AdrienEMSE/PE-SM/Weather_Station_Componants_Pinmaps.xlsx

Sheet: Commandes
Récolte d'énergie |  |  |  |  | Composants passif
Composant | REF | lien | Disponible chez | Quantité | Composant | REF | lien | Disponible chez | Quantité | Disponible au FabLab
~~4.7μH~~ | ~~IHLP2525CZER4R7M01~~ | ~~https://fr.rs-online.com/web/p/inductances-a-montage-en-surface/7487091~~ | ~~RS~~ | ~~10~~ | Résistances
~~10μH~~ | ~~LQH32CN100K23L~~ | ~~https://fr.rs-online.com/web/p/inductances-a-montage-en-surface/4811882~~ | ~~RS~~ | ~~20~~
~~5,62kOhms~~ | ~~679-0576~~ | ~~https://fr.rs-online.com/web/p/resistances-a-montage-en-surface/6790576~~ | ~~RS~~ | ~~50~~
~~1,87kOhms~~ | ~~ 708-7506~~ | ~~https://fr.rs-online.com/web/p/resistances-a-montage-en-surface/7087506~~ | ~~RS~~ | ~~5~~ | 1,87kOhms | 215-2715 | https://fr.rs-online.com/web/p/resistances-a-montage-en-surface/2152715 | RS | 5 | non
~~4,7μF~~ | ~~ 188-2145~~ | ~~https://fr.rs-online.com/web/p/condensateurs-ceramique-multicouches/1882145~~ | ~~RS~~ | ~~25~~ | 5,62kOhms | 679-1575 | https://fr.rs-online.com/web/p/resistances-a-montage-en-surface/6791575 | RS | 50 | non
~~22μF~~ |  | ~~https://fr.rs-online.com/web/p/condensateurs-ceramique-multicouches/9159114~~ | ~~RS~~ | ~~20~~
~~10μF~~ |  | ~~https://fr.rs-online.com/web/p/condensateurs-ceramique-multicouches/6911161~~ | ~~RS~~ | ~~20~~
~~100nF~~
~~1.2k Ohms~~ | ~~565-926~~ | ~~https://fr.rs-online.com/web/p/resistances-a-montage-en-surface/0565926~~ | ~~RS~~ | ~~5~~ | 1.2k Ohms | 565-926 | https://fr.rs-online.com/web/p/resistances-a-montage-en-surface/0565926 | RS | 5 | non
~~1k Ohms~~ |  | ~~j'en ai besoin d'une et dispo par bobines de 5000~~ |  |  | 1k Ohms |  | j'en ai besoin d'une et dispo par bobines de 5000 |  |  | oui
~~100 Ohms~~ | ~~666-2437~~ | ~~https://fr.rs-online.com/web/p/resistances-a-montage-en-surface/6662437~~ | ~~RS~~ | ~~5~~ | 100 Ohms | 666-2437 | https://fr.rs-online.com/web/p/resistances-a-montage-en-surface/6662437 | RS | 5 | oui
 |  |  |  |  | 10k |  |  | RS |  | oui
 |  |  |  |  | 10M |  |  | RS |  | oui
1A, 40V Schotty Diode | 1N5819RL | https://fr.rs-online.com/web/p/diodes-schottky-et-de-redressements/7082197 | RS | 10 | 1k |  |  | RS |  | oui
boost MIC | MIC228YD5-TR | https://fr.rs-online.com/web/p/convertisseurs-dc-dc/9112736 | RS | 10 | 330k |  |  | RS |  | oui
 |  |  |  |  | 100k |  |  | RS |  | oui
 |  |  |  |  | 15k |  | https://fr.rs-online.com/web/p/resistances-a-montage-en-surface/2230584 | RS |  | non
Anémometre ultrasonique |  |  |  |  | Capacités céramique
CD4046B (THT) | 709-1965 | https://fr.rs-online.com/web/p/synthetiseurs-d-horloge/7091965 | RS | 10 | 27pF | 147-409 | https://fr.rs-online.com/web/p/condensateurs-ceramique-multicouches/0147409 | RS | 50 | oui
CD4046B (SMD) | 145-1118 | https://fr.rs-online.com/web/p/synthetiseurs-d-horloge/1451118 | RS (Non disponible) | 10 | 4,7μF | 188-2145 | https://fr.rs-online.com/web/p/condensateurs-ceramique-multicouches/1882145 | RS | 25 | oui
HCSR04 | 215-3181 | https://fr.rs-online.com/web/p/complements-bbc-micro-bit/2153181 | RS | 6 | 22μF |  | https://fr.rs-online.com/web/p/condensateurs-ceramique-multicouches/6911177 | RS | 20 | non
NPN (BSR14) | 671-1129 | https://fr.rs-online.com/web/p/transistors-bipolaires/6711129 | RS | 20 | 10μF |  | https://fr.rs-online.com/web/p/condensateurs-ceramique-multicouches/6911161 | RS | 20 | oui
Détecteur de foudre |  |  |  |  | 100p |  |  | RS |  | oui
 |  |  |  |  | 470p |  | https://fr.rs-online.com/web/p/condensateurs-ceramique-multicouches/2644315 | RS |  | non
Diode | 186-7651 | https://fr.rs-online.com/web/p/diodes-schottky-et-de-redressements/6882136 | RS | 100 | 10n |  |  | RS |  | oui
TS53YL103MR10 | 486-7526 | https://fr.rs-online.com/web/p/potentiometres-trimmer/4867526 | RS | 5 | 4,7n |  |  | RS |  | oui
 |  |  |  |  | 1u |  |  | RS |  | oui
 |  |  |  |  | 0,1u |  | https://fr.rs-online.com/web/p/condensateurs-ceramique-multicouches/1335642 | RS |  | non
MosFET | 822-2520 | https://fr.rs-online.com/web/p/transistors-mosfet/8222520 | RS | 25 | 2200p |  | https://fr.rs-online.com/web/p/condensateurs-ceramique-multicouches/2644359 | RS |  | non
 |  |  |  |  | Capacités électrolitiques
 |  |  |  |  | 100nF |  | https://fr.rs-online.com/web/p/condensateurs-electrolytiques-aluminium/8388005 | RS |  | non
 |  |  |  |  | 47u |  | https://fr.rs-online.com/web/p/condensateurs-electrolytiques-aluminium/5370657 | RS |  | non
 |  |  |  |  | Bobines
 |  |  |  |  | 4.7μH | IHLP2525CZER4R7M01 | https://fr.rs-online.com/web/p/inductances-a-montage-en-surface/7487091 | RS |  | non
 |  |  |  |  | 10μH | LQH32CN100K23L | https://fr.rs-online.com/web/p/inductances-a-montage-en-surface/4811882 | RS |  | oui

Sheet: Sensors
Sensor | Alimentation | Communication | Digital Pins | Analog Pins | Consommation moyenne th. (uA) | Placement
Air Quality + Humidity + T° + Pression | 5V | I2C1 | 1 | 0 |  | Shield Nucléo 144
GPS | 5V | Virtual UART | 0 | 0 |  | Shield Nucléo 144
DHT | 5V | Custom | 0 | 0 |  | Shield Nucléo 144
Sky Temperature | 5V | I2C2 | 0 | 0 |  | PCB Déporté
UV | 5V | I2C1 | 0 | 0 |  | PCB Déporté
Rain Detector | ∅ | ∅ | 1 | 1 |  | PCB Déporté
Brightness | 5V | I2C1 | 0 | 0 |  | PCB Déporté
Wind Gauge | 5V | ∅ | 0 | 2 |  | PCB Custom
Lightning Detector | 5V | ∅ | 0 | 1 | 600 | PCB Custom
Air Quality | 5V | UART | 0 | 0 |  | Nucléo Raspi
CO2 | 5V | Virtual UART | 0 | 0 |  | Nucléo Raspi

Sheet: PinList
Analog Pins |  | Digital Pins |  | Communication Pins
Anémomètre Phase 1 | A1 | Pluviomètre Trigger | D2 | I2C1 - SDA | D14
Anémomètre Phase 2 | A2 | Wake_css | D5 | I2C1 - SCL | D15
Signal Foudre | A3 | Reprogrammation_ESP | PG2 | I2C2 - SDA | PB11
Mesure Pluviomètre | A4 | Alimentation_GPS | D8 | I2C2 - SCL | PB10
 |  | Alimentation_DHT | D9 | UART1 - Rx | PB15
 |  | Alimentation_Skytemp | D10 | UART1 - Tx | PB6
 |  | Alimentation_pluviometre | D11 | UART3 - Rx | PD9
 |  | Acc_UV | PE_12 | UART3 - Tx | PD8
 |  | Alimentation_ESP | D13 | UART7 - Rx | PE7
 |  | Alimentation_anemo | PE_10 | UART7 - Tx | PE8
 |  |  |  | UART_ESP- GPIO13 (Rx) | D0
 |  |  |  | UART_ESP - GPIO15 (Tx) | ²
 |  |  |  | UART_GPS - Rx | D4
 |  |  |  | UART_GPS - Tx | D7
 |  |  |  | Custom_DHT | D3
 |  |  |  | SPI4 - MOSI | PE6
 |  |  |  | SPI4 - MISO | PE5
 |  |  |  | SPI4 - SCK | PE2
 |  |  |  | SPI4 - CS | PE4

Sheet: Feuille 7
Anémomètre Phase 1 | A1
Anémomètre Phase 2 | A2
Signal Foudre | A3
Mesure Pluviomètre | A4
UART_ESP - Rx | D0
UART_ESP - Tx | D1
I2C1 - SDA | D14
I2C1 - SCL | D15
Pluviomètre Trigger | D2
Custom_DHT | D3
UART_GPS - Rx | D4
Sleep_Air_Quality | D5
UART_GPS - Tx | D7
I2C2 - SCL | PB10
I2C2 - SDA | PB11
UART1 - Rx | PB15
UART1 - Tx | PB6
UART3 - Tx | PD8
UART3 - Rx | PD9
UART7 - Rx | PE7
UART7 - Tx | PE8
Reprogrammation_ESP | PG2

Sheet: PinList Serveur
Raspberry |  | Nucleo L432KC |  | PM25 | C02
5V | 2 | 5V | CH4 5V | 5V | 5V
GND | 6 | GND | CH4 GND | GND | GND
UART_Nucleo_RX_RPi_TX | 8 | UART_Nucleo_RX_RPi_TX | A2 | TX | TX
UART_RPi_RX_Nucleo_TX | 10 | UART_Nucleo_TX_RPi_RX | A7 | RX | RX
 |  | UART2_Nucleo_RX_PM25_TX | D0
 |  | UART2_Nucleo_TX_PM25_RX | D1
 |  | UART3_Nucleo_RX_CO2_TX | D2
 |  | UART3_Nucleo_TX_CO2_RX | D3
