AdrienEMSE/PE-SM/3D/Nucleo/NUCLEO-F429ZI--3DModel-STEP-56544.SLDASM

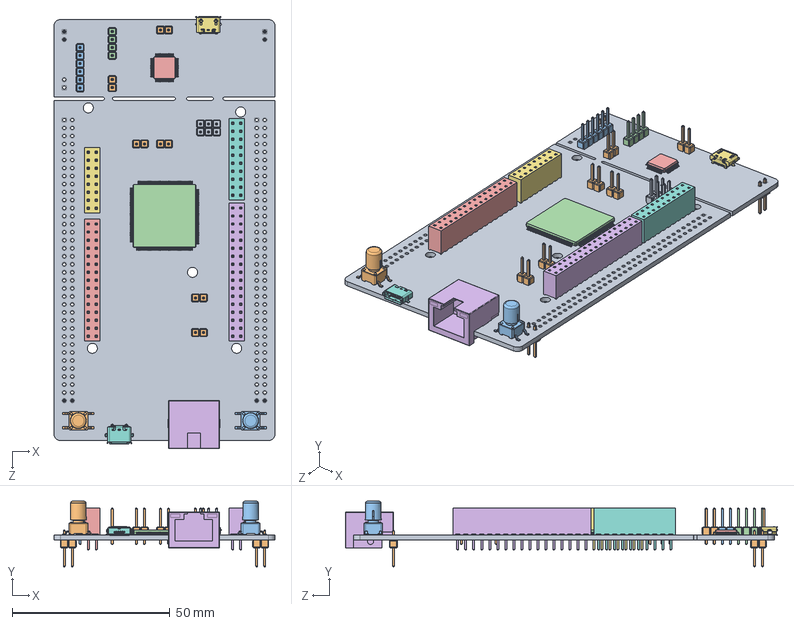
[picture p24: CAD file, 2023-03-29]
3D/Nucleo/NUCLEO-F429ZI--3DModel-STEP-56544.SLDASM
70.0 x 20.8 x 137.0 mm
NUCLEO-F429ZI board
jp1 x 10
cn6
cn4
cn9
cn10
cn1
cn13
jp3
b1
b2
STM32lqfp144
STM32F103CBT6
lan
cn8
cn7
