AdrienEMSE/PE-SM/3D/Aeration.stl

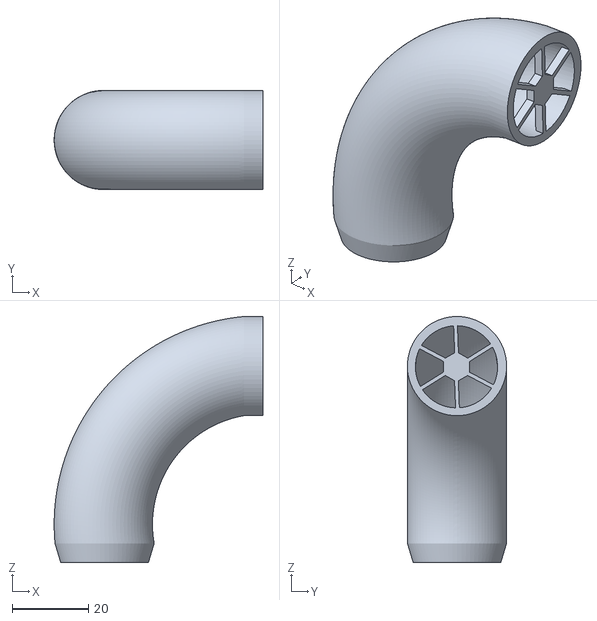
[picture p25: CAD file, 2023-03-29]
3D/Aeration.stl
54.7 x 26.0 x 64.5
