AdrienEMSE/PE-SM/3D/Door.stl

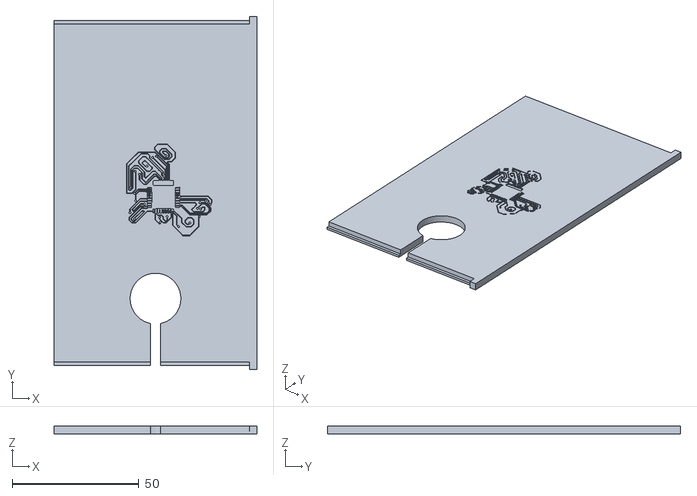
[picture p26: CAD file, 2023-03-29]
3D/Door.stl
80.0 x 139.2 x 3.00
