AdrienEMSE/PE-SM/3D/BatterieHolder.stl

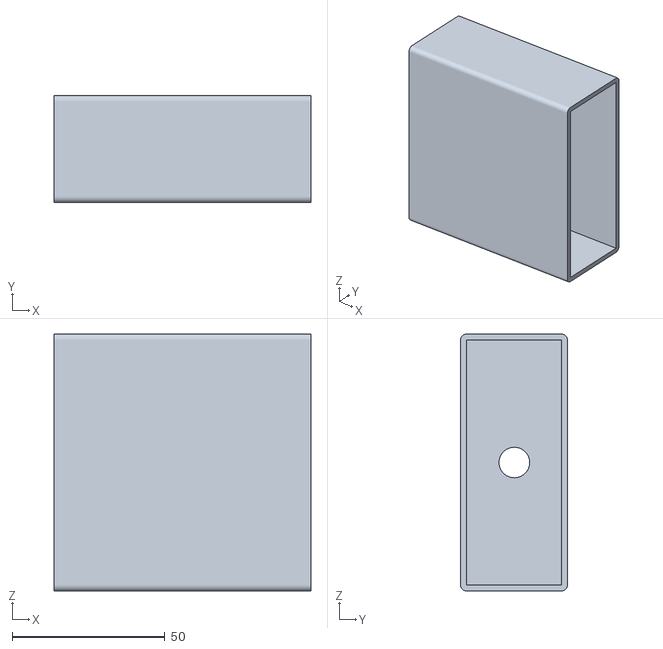
[picture p27: CAD file, 2023-03-29]
3D/BatterieHolder.stl
84.0 x 35.0 x 84.0
