AdrienEMSE/PE-SM/3D/cache_batterie_1.stl

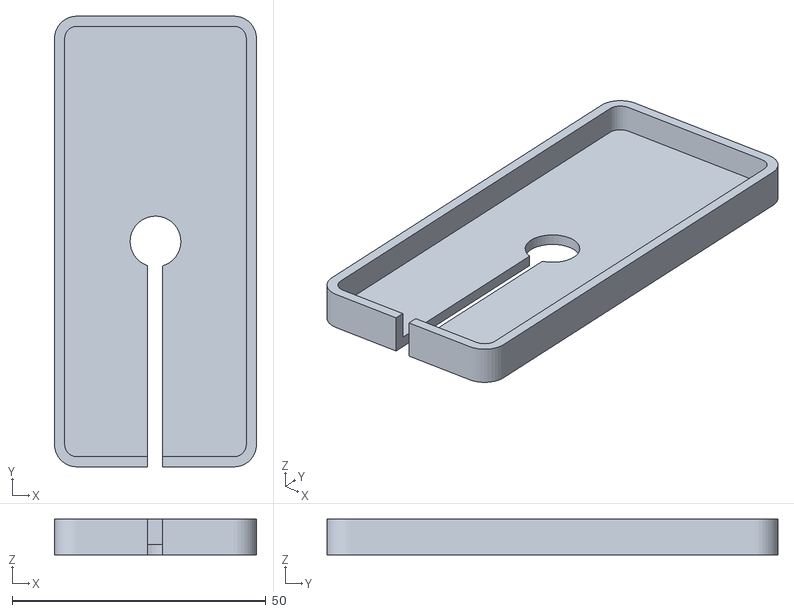
[picture p28: CAD file, 2023-03-29]
3D/cache_batterie_1.stl
39.8 x 88.8 x 7.00
