AdrienEMSE/PE-SM/3D/Cache_remote.stl

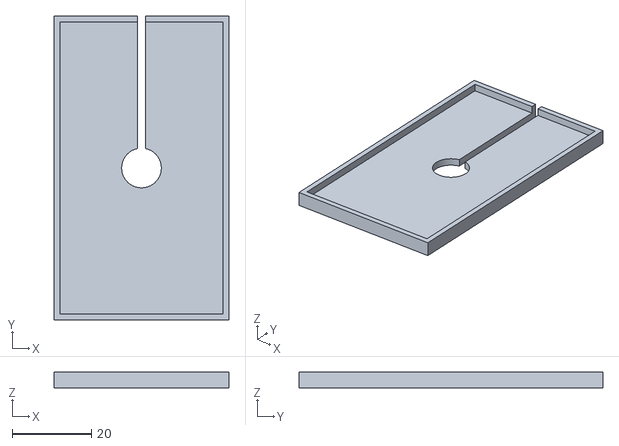
[picture p29: CAD file, 2023-03-29]
3D/Cache_remote.stl
44.0 x 76.6 x 4.00
