AdrienEMSE/PE-SM/3D/AnemoHolder.stl

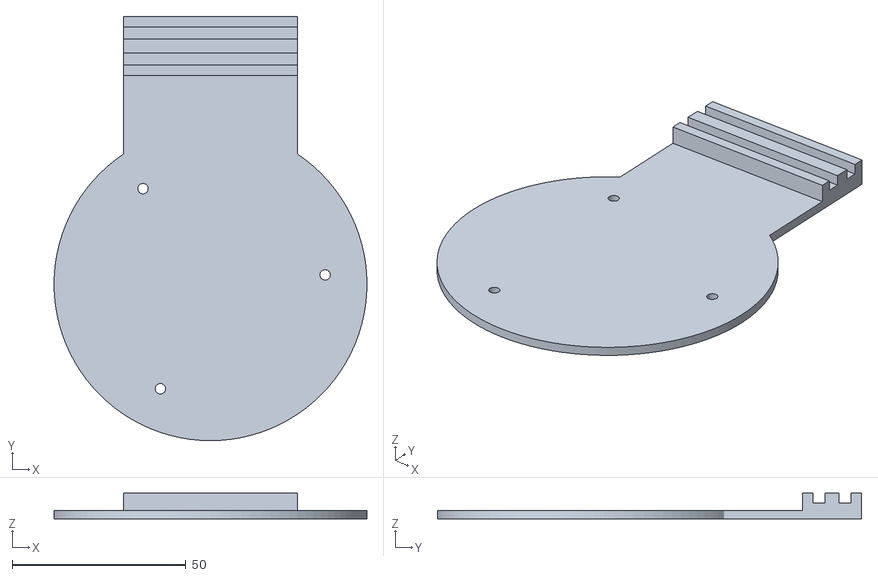
[picture p30: CAD file, 2023-03-29]
3D/AnemoHolder.stl
90.0 x 122.0 x 7.40
