AdrienEMSE/PE-SM/3D/PE.stl

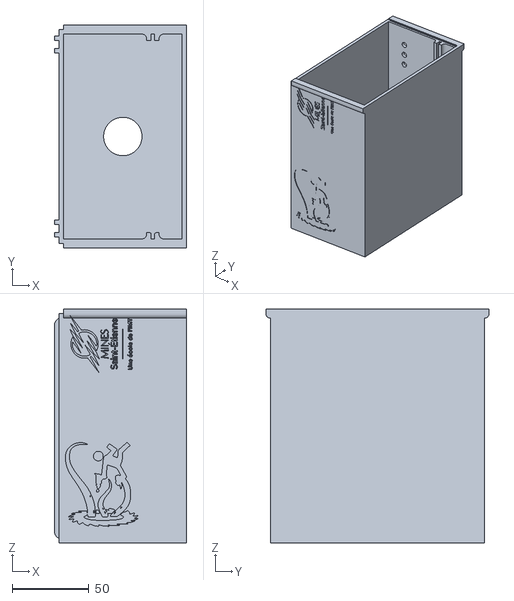
[picture p31: CAD file, 2023-03-29]
3D/PE.stl
86.0 x 145.2 x 152.2
