AdrienEMSE/PE-SM/3D/rainHolder.stl

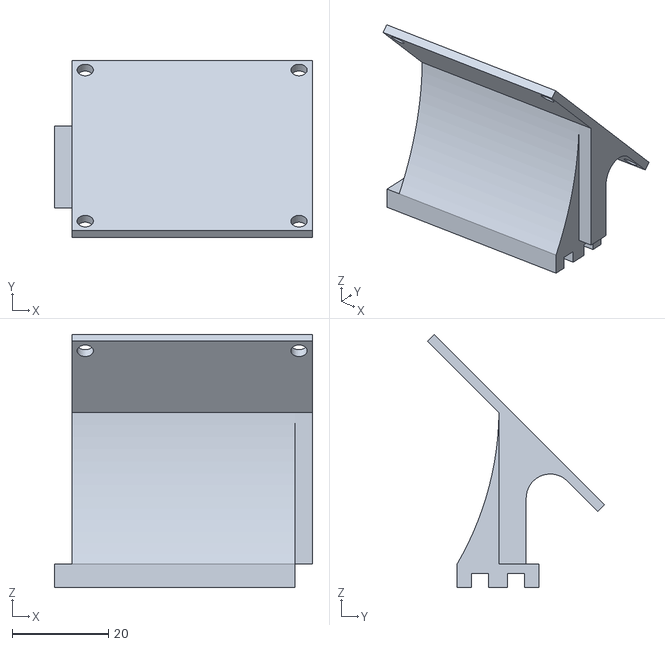
[picture p32: CAD file, 2023-03-29]
3D/rainHolder.stl
53.6 x 36.8 x 52.6
