AdrienEMSE/PE-SM/3D/SolarPanelHolder.stl

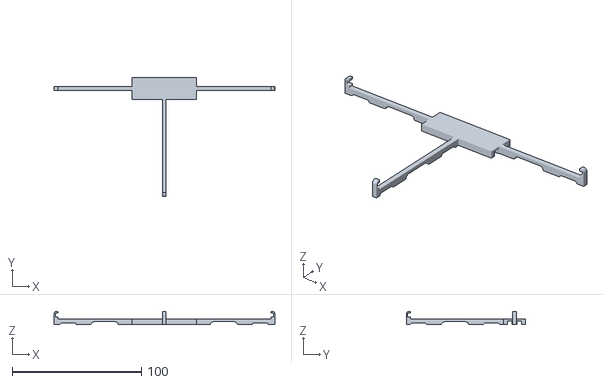
[picture p33: CAD file, 2023-03-29]
3D/SolarPanelHolder.stl
171.0 x 92.2 x 10.4
