AdrienEMSE/PE-SM/3D/Remote.stl

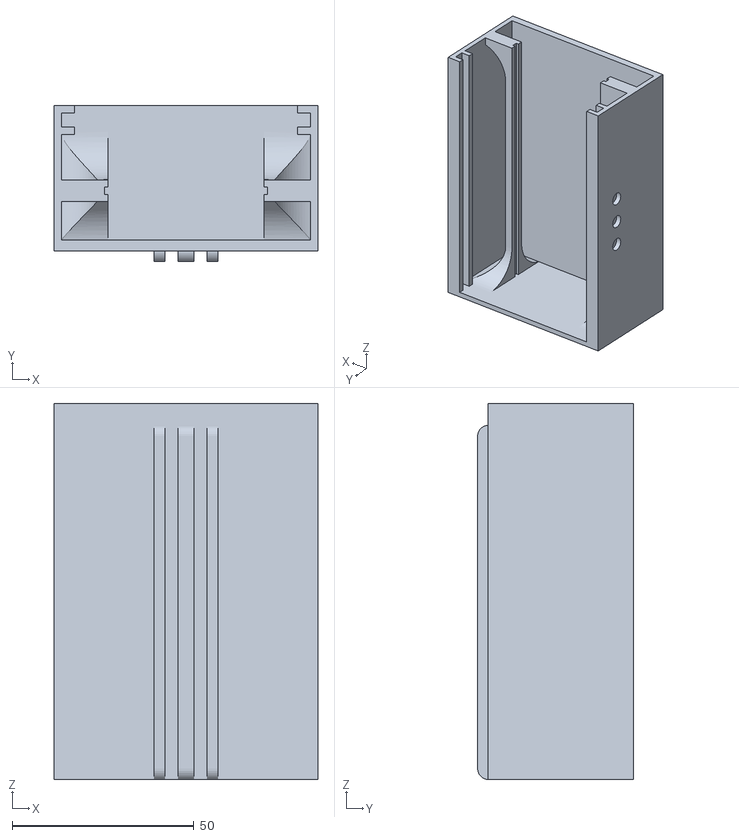
[picture p34: CAD file, 2023-03-29]
3D/Remote.stl
72.6 x 42.9 x 103.5
