AdrienEMSE/PE-SM/3D/clips Anemo.3mf

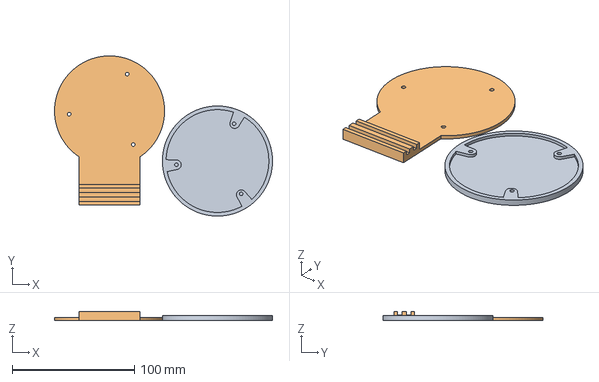
[picture p35: CAD file, 2023-03-29]
3D/clips Anemo.3mf
178.2 x 130.9 x 7.40 mm
clips Anemo.stl
AnemoHolder.stl
