AdrienEMSE/PE-SM/(list of files, cad)

Other CAD files:
3D/Nucleo/cn13.sldprt
3D/Nucleo/lan.sldprt
3D/Nucleo/NUCLEO-F429ZI board.sldprt
3D/Nucleo/STM32lqfp144.sldprt
3D/Nucleo/jp3.sldprt
3D/Nucleo/cn8.sldprt
3D/Nucleo/cn6.sldprt
3D/Nucleo/cn7.sldprt
3D/Nucleo/cn4.sldprt
3D/Nucleo/cn10.sldprt
3D/Nucleo/cn1.sldprt
3D/Nucleo/b2.sldprt
3D/Nucleo/cn9.sldprt
3D/Nucleo/b1.sldprt
3D/Nucleo/jp1.sldprt
3D/Nucleo/STM32F103CBT6.sldprt
3D/Aeration.ipt
3D/AnemoHolder.ipt
3D/Anemometre-v1.f3d
3D/Anemometre-v1.ipt
3D/BatterieHolder.ipt
3D/Cache_batterie.ipt
3D/Cache_remote.ipt
3D/Door.ipt
3D/Ensemble.iam
3D/OldVersions/AnemoHolder.0002.ipt
3D/OldVersions/BatterieHolder.0002.ipt
3D/OldVersions/Ensemble.0001.iam
3D/OldVersions/cache_batterie_1.0001.ipt
3D/Remote.iam
3D/Remote.ipt
3D/SolarPanelHolder.ipt
3D/batterieEtCacheBatterie.iam
3D/cache_batterie_1.ipt
3D/clips Anemo.ipt
3D/clips Anemo.stl
3D/rainHolder.ipt
3D/raspberry 3d case/base.ipt
3D/raspberry 3d case/piece_interieur.ipt
3D/raspberry 3d case/pied.ipt
