AdrienEMSE/PE-SM/3D/Nucleo/NUCLEO-F429ZI--3DModel-STEP-56544-2.JPG

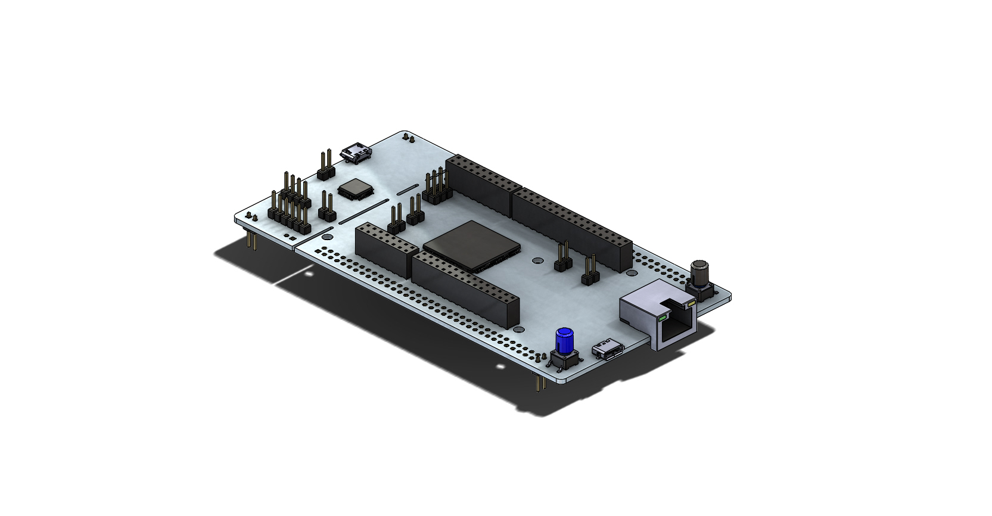
3D/Nucleo/NUCLEO-F429ZI--3DModel-STEP-56544-2.JPG
