AdrienEMSE/PE-SM/Kicad/Shield_Nucleo144/Shield_Nucleo144.kicad_pcb

## KiCad design Kicad/Shield_Nucleo144/Shield_Nucleo144.kicad_pcb (2023-03-29)

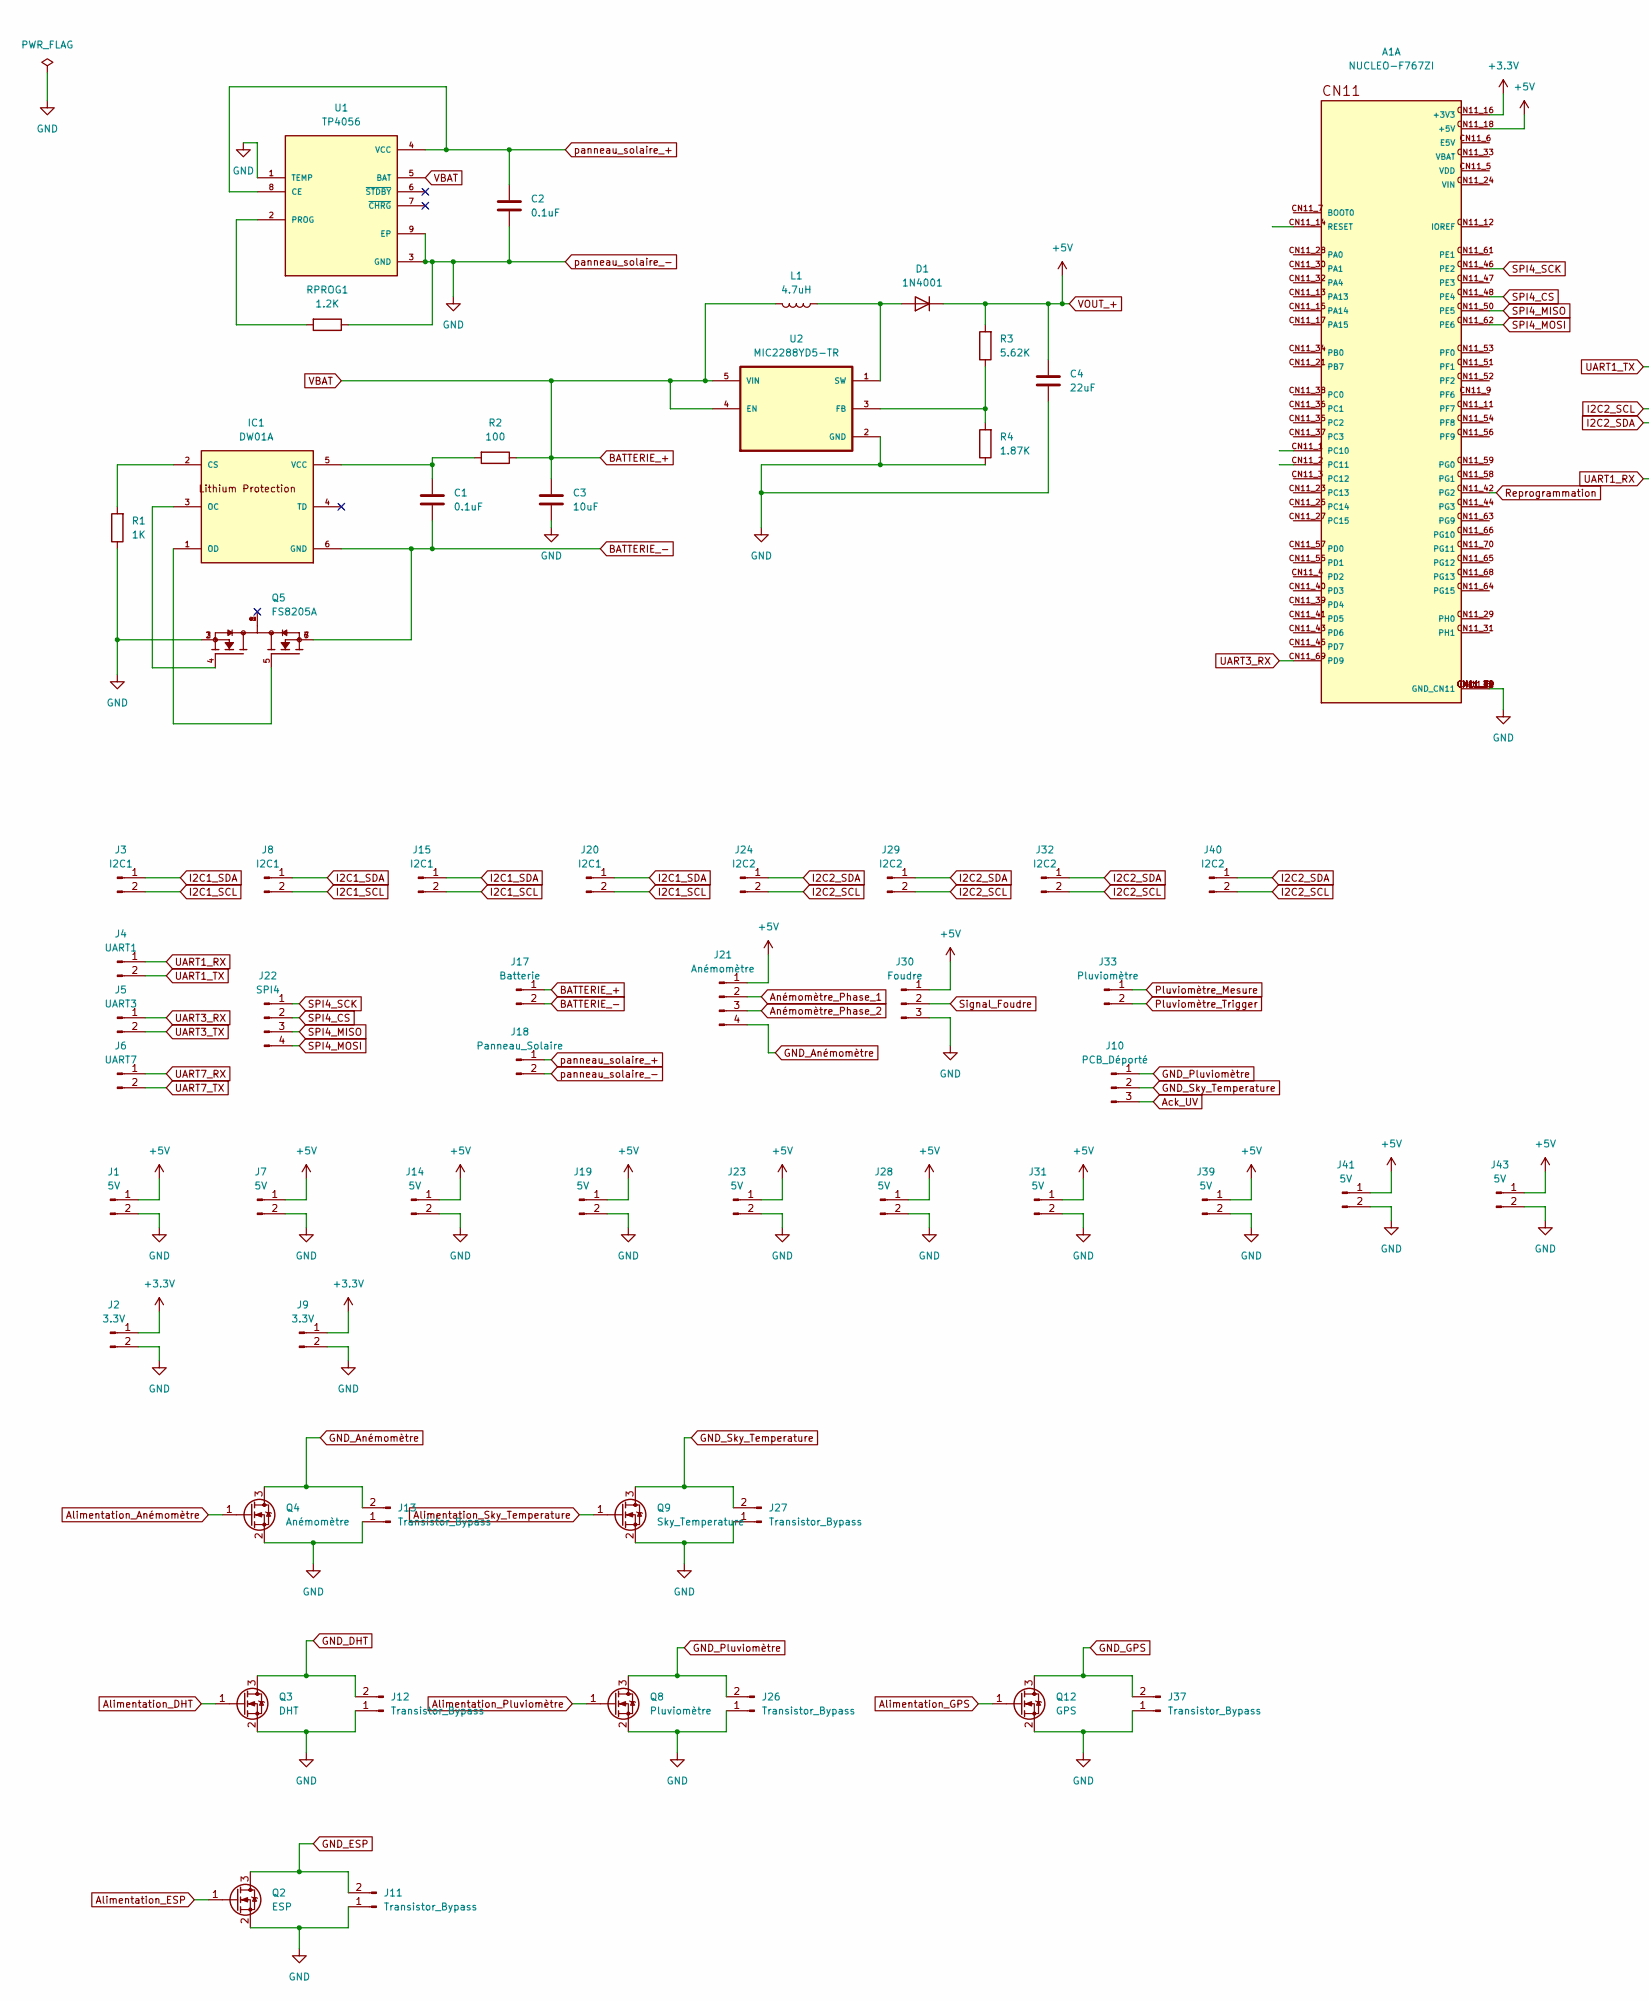
[picture p38: schematic Shield_Nucleo144.kicad_sch, part in row 1, column 1]

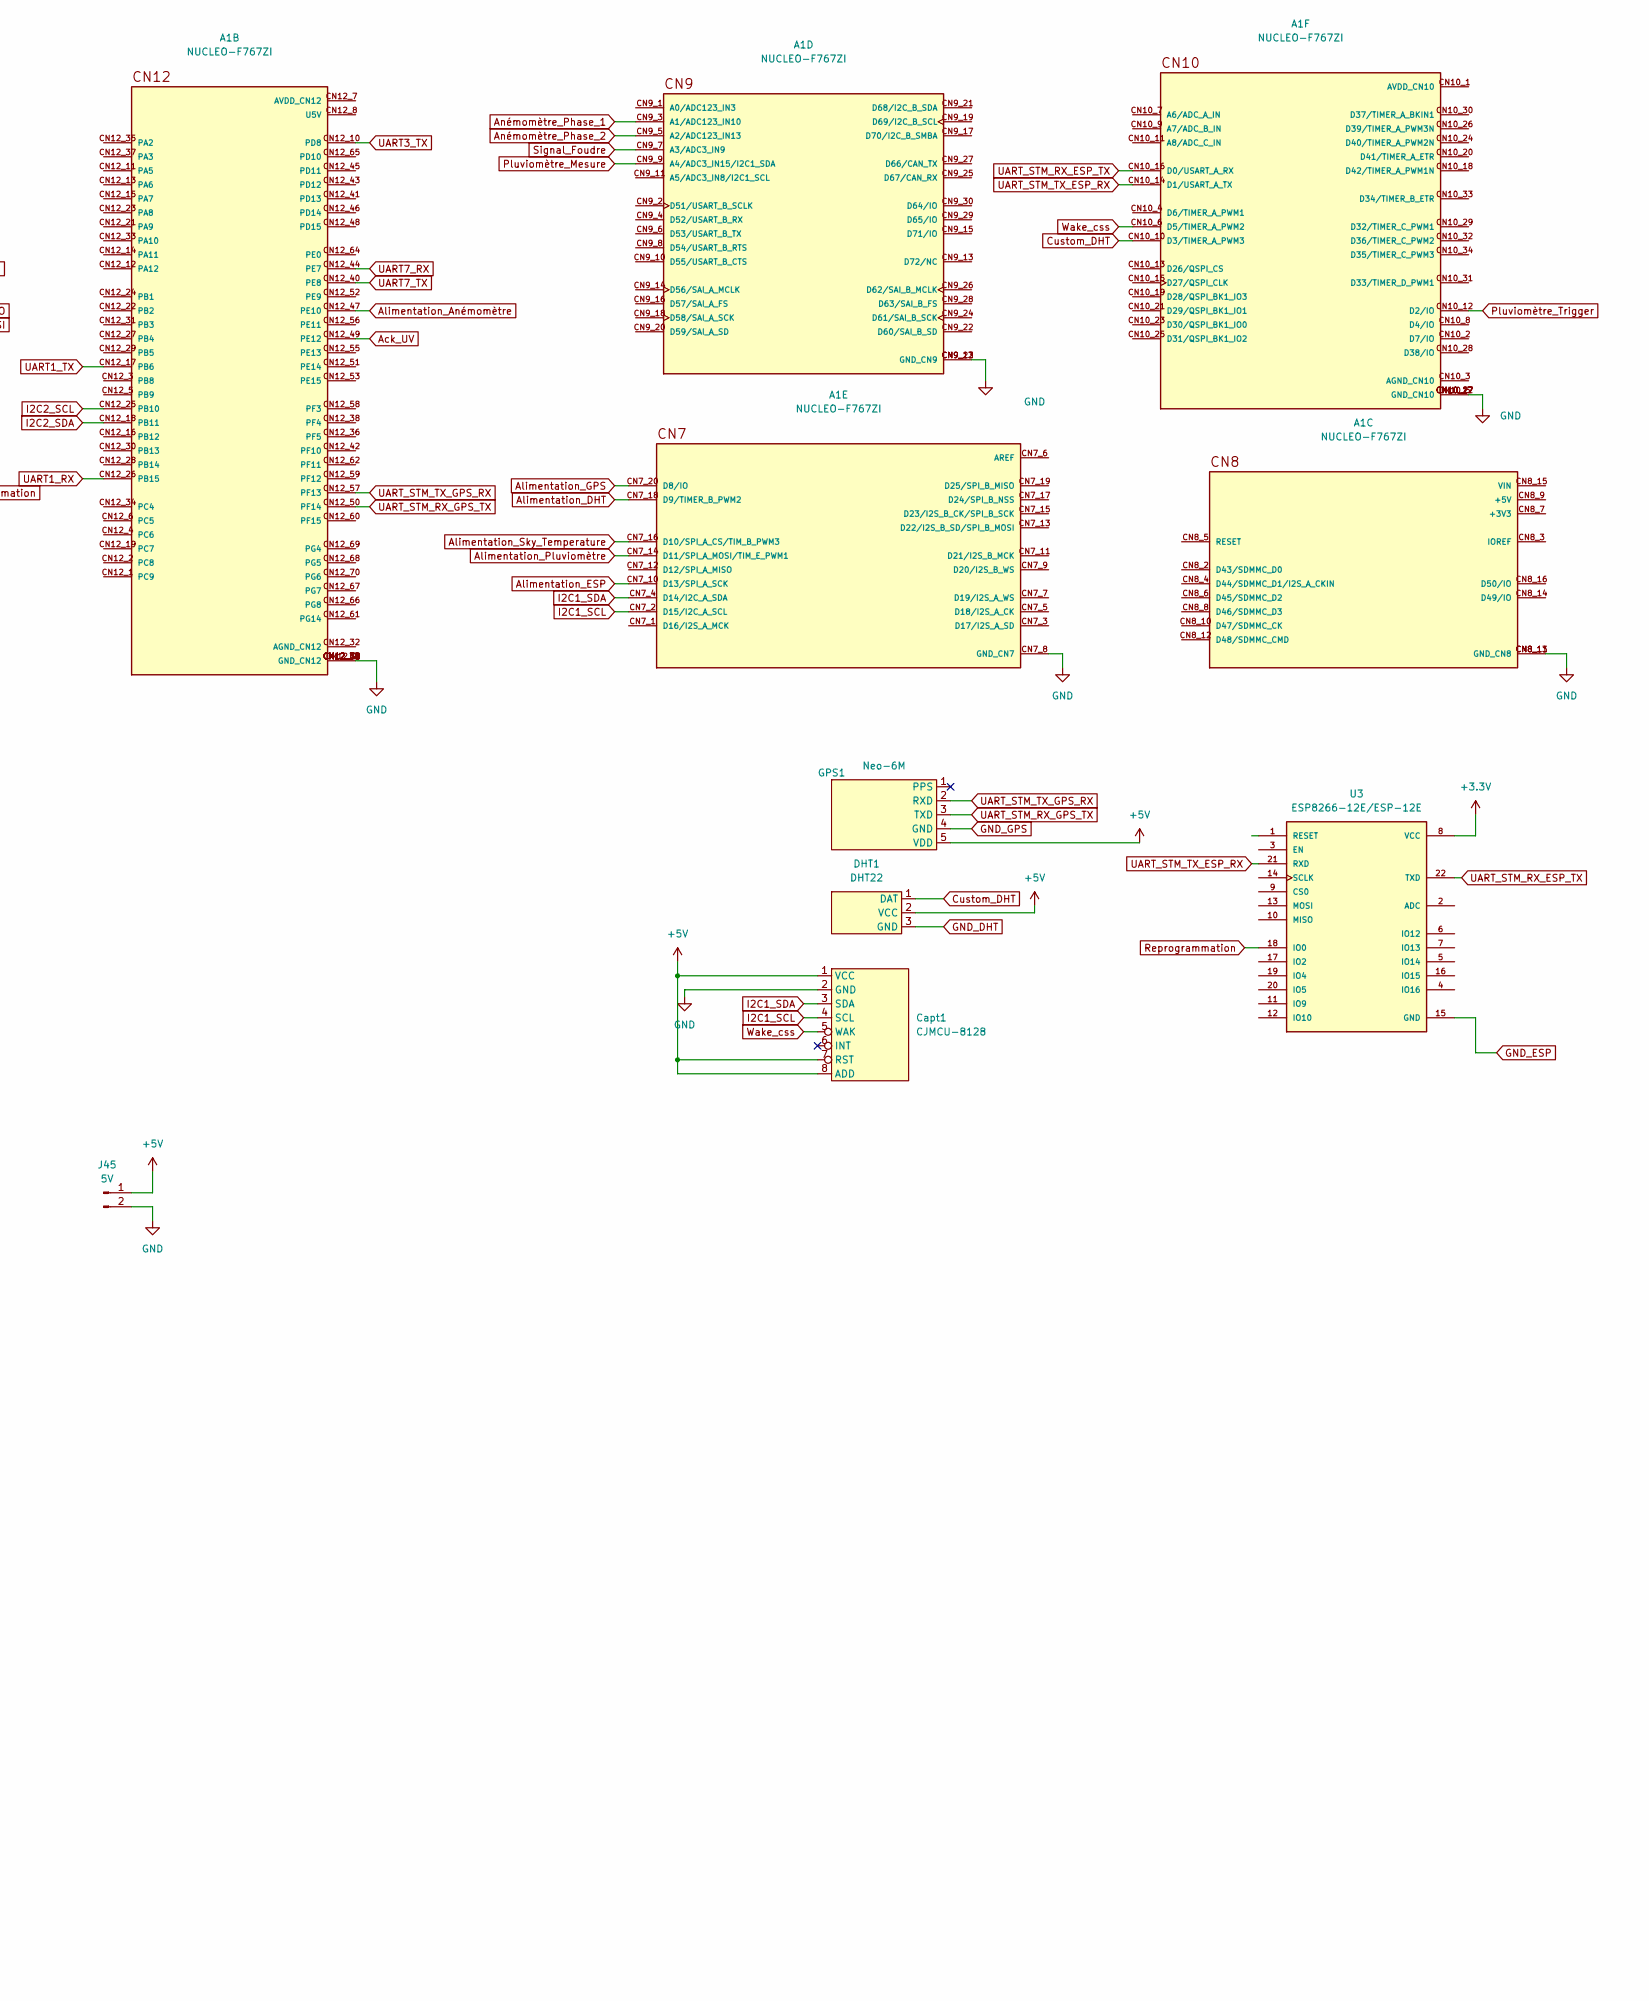
[picture p39: schematic Shield_Nucleo144.kicad_sch, part in row 1, column 2]

Parts:
A1: NUCLEO-F767ZI; ST_NUCLEO-F767ZI; PARTREV 7
C1, C2: 0.1uF; C_0603_1608Metric
C3: 10uF; C_0603_1608Metric
C4: 22uF; C_0805_2012Metric
Capt1: CJMCU-8128; AQHT
D1: 1N4001; D_SOD-123
DHT1: DHT22; DHT
GPS1: Neo-6M; GPS
IC1: DW01A; SOT-23-6; MPN DW01A; LCSC C351410
J1, J7, J14, J19, J23, J28, J31, J39, J41, J43, J45: 5V; JST_EH_B2B-EH-A_1x02_P2.50mm_Vertical
J2, J9: 3.3V; JST_EH_B2B-EH-A_1x02_P2.50mm_Vertical
J3, J8, J15, J20: I2C1; JST_EH_B2B-EH-A_1x02_P2.50mm_Vertical
J4: UART1; JST_EH_B2B-EH-A_1x02_P2.50mm_Vertical
J5: UART3; JST_EH_B2B-EH-A_1x02_P2.50mm_Vertical
J6: UART7; JST_EH_B2B-EH-A_1x02_P2.50mm_Vertical
J10: PCB_Déporté; JST_EH_B3B-EH-A_1x03_P2.50mm_Vertical
J11, J12, J13, J26, J27, J37: Transistor_Bypass; PinHeader_1x02_P2.54mm_Vertical
J17: Batterie; JST_EH_B2B-EH-A_1x02_P2.50mm_Vertical
J18: Panneau_Solaire; JST_EH_B2B-EH-A_1x02_P2.50mm_Vertical
J21: Anémomètre; JST_EH_B4B-EH-A_1x04_P2.50mm_Vertical
J22: SPI4; JST_EH_B4B-EH-A_1x04_P2.50mm_Vertical
J24, J29, J32, J40: I2C2; JST_EH_B2B-EH-A_1x02_P2.50mm_Vertical
J30: Foudre; JST_EH_B3B-EH-A_1x03_P2.50mm_Vertical
J33: Pluviomètre; JST_EH_B2B-EH-A_1x02_P2.50mm_Vertical
L1: 4.7uH; L_Vishay_IHLP-2525
Q2: ESP; SOT-23
Q3: DHT; SOT-23
Q4: Anémomètre; SOT-23
Q5: FS8205A; SOP65P640X120-8N; PARTREV 1.7
Q8: Pluviomètre; SOT-23
Q9: Sky_Temperature; SOT-23
Q12: GPS; SOT-23
R1: 1K; R_0603_1608Metric
R2: 100; R_0603_1608Metric
R3: 5.62K; R_0805_2012Metric
R4: 1.87K; R_0805_2012Metric
RPROG1: 1.2K; R_0805_2012Metric
U1: TP4056; SOP127P600X175-9N
U2: MIC2288YD5-TR; TSOT-23-5; PARTREV B
U3: ESP8266-12E/ESP-12E; ESP8233

Connections:
+3.3V: A1.CN11_16 (+3V3), J2.1, J9.1, U3.8 (VCC)
Ack_UV: A1.CN12_49 (PE12), J10.3
Alimentation_Anémomètre: A1.CN12_47 (PE10), Q4.1 (G)
Alimentation_DHT: A1.CN7_18 (D9/TIMER_B_PWM2), Q3.1 (G)
Alimentation_ESP: A1.CN7_10 (D13/SPI_A_SCK), Q2.1 (G)
Alimentation_GPS: A1.CN7_20 (D8/IO), Q12.1 (G)
Alimentation_Pluviomètre: A1.CN7_14 (D11/SPI_A_MOSI/TIM_E_PWM1), Q8.1 (G)
Alimentation_Sky_Temperature: A1.CN7_16 (D10/SPI_A_CS/TIM_B_PWM3), Q9.1 (G)
Anémomètre_Phase_1: A1.CN9_3 (A1/ADC123_IN10), J21.2
Anémomètre_Phase_2: A1.CN9_5 (A2/ADC123_IN13), J21.3
BATTERIE_+: C3.1, J17.1, L1.2, R2.1, U1.5 (BAT), U2.4 (EN), U2.5 (VIN)
BATTERIE_-: C1.2, IC1.6 (GND), J17.2, Q5.6, Q5.7
Custom_DHT: A1.CN10_10 (D3/TIMER_A_PWM3), DHT1.1 (DAT)
GND_Anémomètre: J13.2, J21.4, Q4.3 (D)
GND_DHT: DHT1.3 (GND), J12.2, Q3.3 (D)
GND_ESP: J11.2, Q2.3 (D), U3.15 (GND)
GND_GPS: GPS1.4 (GND), J37.2, Q12.3 (D)
GND_Pluviomètre: J10.1, J26.2, Q8.3 (D)
GND_Sky_Temperature: J10.2, J27.2, Q9.3 (D)
I2C1_SCL: A1.CN7_2 (D15/I2C_A_SCL), Capt1.4 (SCL), J3.2, J8.2, J15.2, J20.2
I2C1_SDA: A1.CN7_4 (D14/I2C_A_SDA), Capt1.3 (SDA), J3.1, J8.1, J15.1, J20.1
I2C2_SCL: A1.CN12_25 (PB10), J24.2, J29.2, J32.2, J40.2
I2C2_SDA: A1.CN12_18 (PB11), J24.1, J29.1, J32.1, J40.1
unnamed: C1.1, IC1.5 (VCC), R2.2
unnamed: D1.2 (A), L1.1, U2.1 (SW)
unnamed: IC1.1 (OD), Q5.5
unnamed: IC1.2 (CS), R1.2
unnamed: IC1.3 (OC), Q5.4
unnamed: R3.1, R4.2, U2.3 (FB)
unnamed: RPROG1.2, U1.2 (PROG)
Pluviomètre_Mesure: A1.CN9_9 (A4/ADC3_IN15/I2C1_SDA), J33.1
Pluviomètre_Trigger: A1.CN10_12 (D2/IO), J33.2
Reprogrammation: A1.CN11_42 (PG2), U3.18 (IO0)
SPI4_CS: A1.CN11_48 (PE4), J22.2
SPI4_MISO: A1.CN11_50 (PE5), J22.3
SPI4_MOSI: A1.CN11_62 (PE6), J22.4
SPI4_SCK: A1.CN11_46 (PE2), J22.1
Signal_Foudre: A1.CN9_7 (A3/ADC3_IN9), J30.2
UART1_RX: A1.CN12_26 (PB15), J4.1
UART1_TX: A1.CN12_17 (PB6), J4.2
UART3_RX: A1.CN11_69 (PD9), J5.1
UART3_TX: A1.CN12_10 (PD8), J5.2
UART7_RX: A1.CN12_44 (PE7), J6.1
UART7_TX: A1.CN12_40 (PE8), J6.2
UART_STM_RX_ESP_TX: A1.CN10_16 (D0/USART_A_RX), U3.22 (TXD)
UART_STM_RX_GPS_TX: A1.CN12_50 (PF14), GPS1.3 (TXD)
UART_STM_TX_ESP_RX: A1.CN10_14 (D1/USART_A_TX), U3.21 (RXD)
UART_STM_TX_GPS_RX: A1.CN12_57 (PF13), GPS1.2 (RXD)
VOUT_+: A1.CN11_18 (+5V), C4.1, Capt1.1 (VCC), Capt1.7 (RST), Capt1.8 (ADD), D1.1 (K), DHT1.2 (VCC), GPS1.5 (VDD), J1.1, J7.1, J14.1, J19.1, J21.1, J23.1, J28.1, J30.1, J31.1, J39.1, J41.1, J43.1, J45.1, R3.2
Wake_css: A1.CN10_6 (D5/TIMER_A_PWM2), Capt1.5 (WAK)
panneau_solaire_+: C2.1, J18.1, U1.4 (VCC), U1.8 (CE)
panneau_solaire_-: A1.CN7_8 (GND_CN7), A1.CN8_11 (GND_CN8), A1.CN8_13 (GND_CN8), A1.CN9_12 (GND_CN9), A1.CN9_23 (GND_CN9), A1.CN10_5 (GND_CN10), A1.CN10_17 (GND_CN10), A1.CN10_22 (GND_CN10), A1.CN10_27 (GND_CN10), A1.CN11_8 (GND_CN11), A1.CN11_19 (GND_CN11), A1.CN11_20 (GND_CN11), A1.CN11_22 (GND_CN11), A1.CN11_49 (GND_CN11), A1.CN11_60 (GND_CN11), A1.CN11_71 (GND_CN11), A1.CN11_72 (GND_CN11), A1.CN12_9 (GND_CN12), A1.CN12_20 (GND_CN12), A1.CN12_39 (GND_CN12), A1.CN12_54 (GND_CN12), A1.CN12_63 (GND_CN12), A1.CN12_71 (GND_CN12), A1.CN12_72 (GND_CN12), C2.2, C3.2, C4.2, Capt1.2 (GND), J1.2, J2.2, J7.2, J9.2, J11.1, J12.1, J13.1, J14.2, J18.2, J19.2, J23.2, J26.1, J27.1, J28.2, J30.3, J31.2, J37.1, J39.2, J41.2, J43.2, J45.2, Q2.2 (S), Q3.2 (S), Q4.2 (S), Q5.2, Q5.3, Q8.2 (S), Q9.2 (S), Q12.2 (S), R1.1, R4.1, RPROG1.1, U1.1 (TEMP), U1.3 (GND), U1.9 (EP), U2.2 (GND)

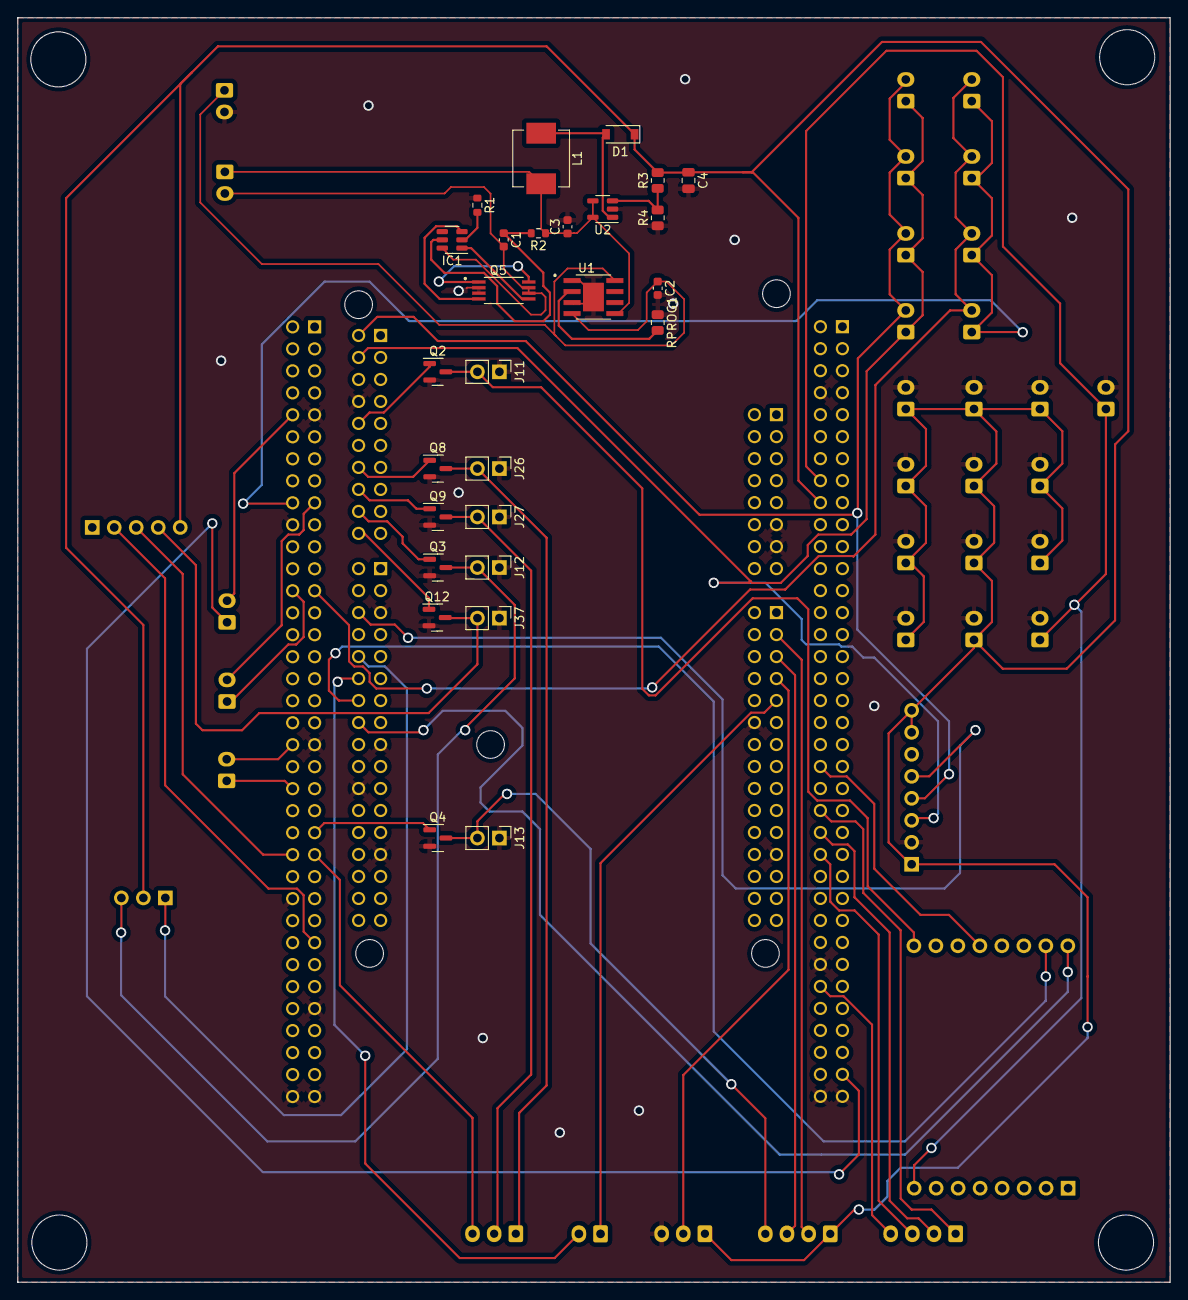
[picture p40: board Shield_Nucleo144.kicad_pcb from above]

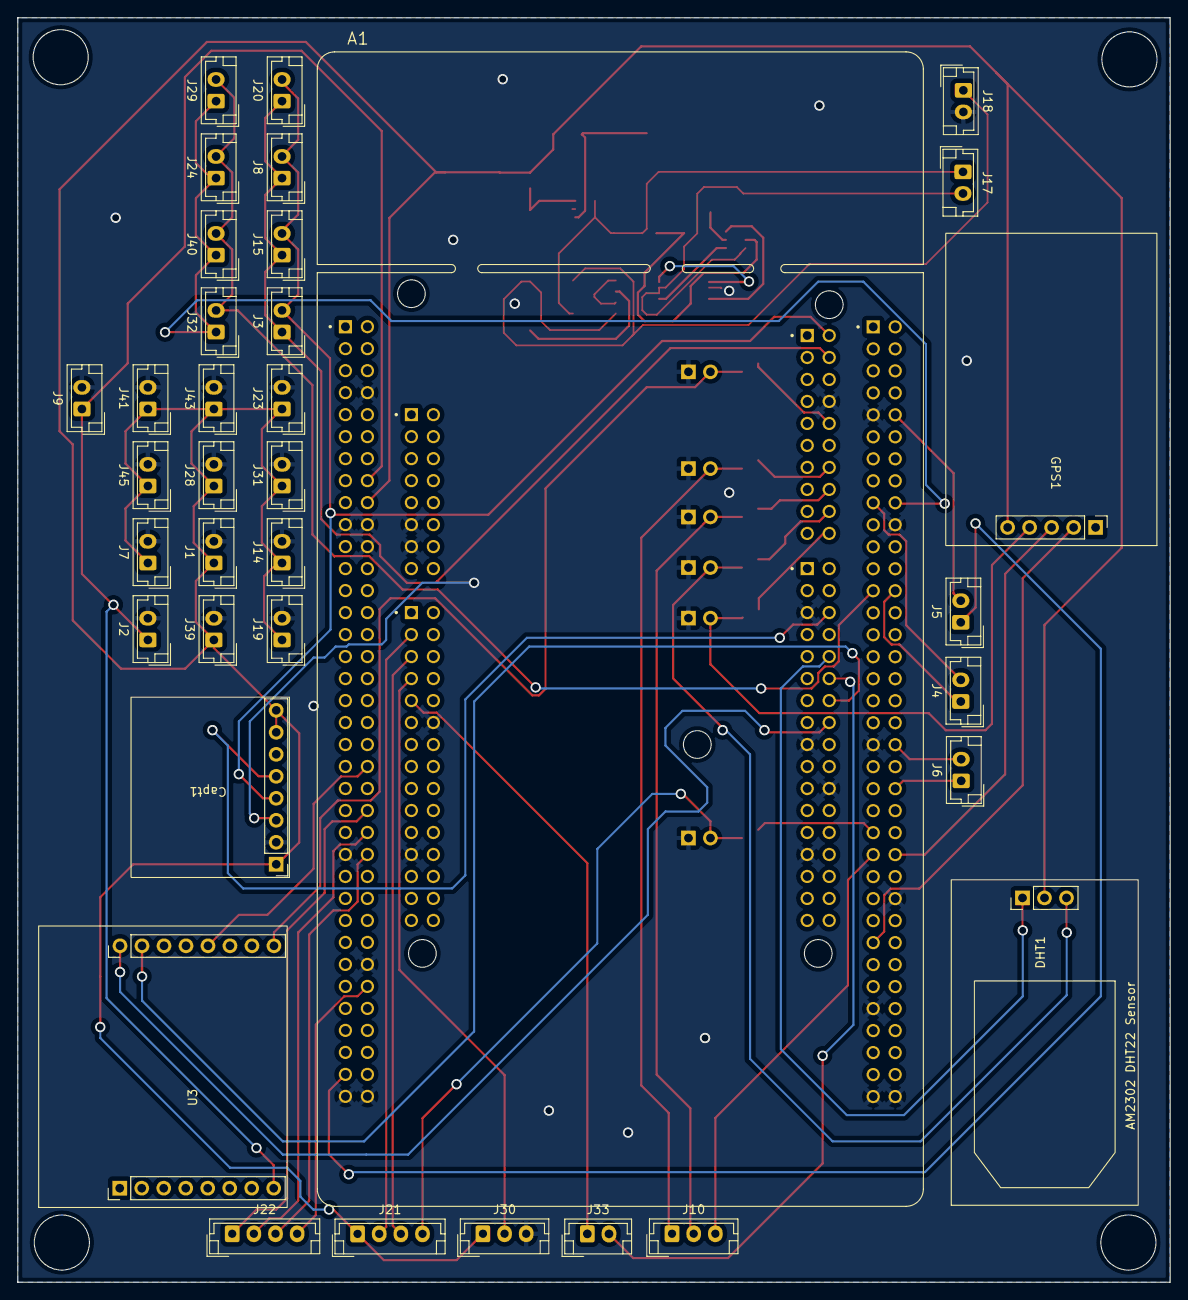
[picture p41: board Shield_Nucleo144.kicad_pcb from below]

Board: 2 copper layers, 133.1 x 146.0 mm, 63 parts (36 on the bottom side), 52 nets.
