AdrienEMSE/PE-SM/Kicad/Shield_Raspy/Shield_Raspy.kicad_pcb

## KiCad design Kicad/Shield_Raspy/Shield_Raspy.kicad_pcb (2023-03-29)

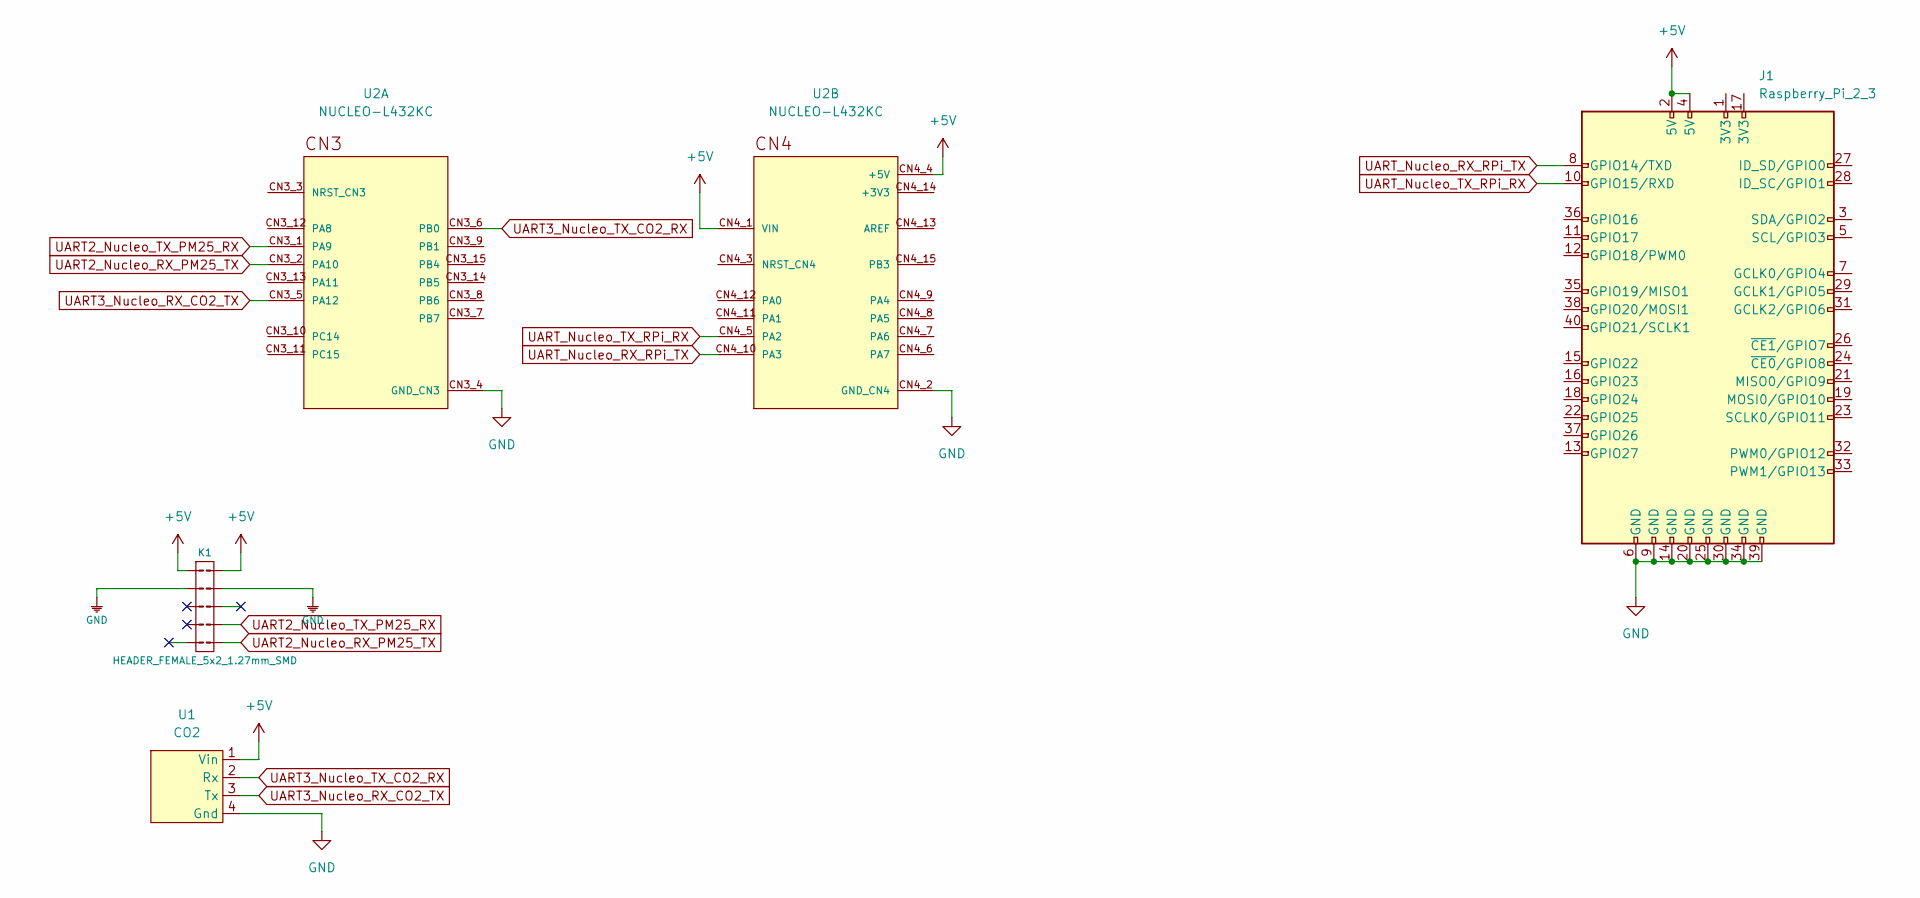
[picture p42: schematic Shield_Raspy.kicad_sch]

Parts:
J1: Raspberry_Pi_2_3; MODULE_RASPBERRY_PI_3_MODEL_B+
K1: HEADER_FEMALE_5x2_1.27mm_SMD; PinHeader_2x05_P1.27mm_Vertical
U1: CO2
U2: NUCLEO-L432KC; MODULE_NUCLEO-L432KC; PARTREV N/A

Connections:
+5V: J1.2 (5V), J1.4 (5V), K1.1, K1.2, U1.1 (Vin), U2.CN4_1 (VIN)
GND: J1.6 (GND), J1.9 (GND), J1.14 (GND), J1.20 (GND), J1.25 (GND), J1.30 (GND), J1.34 (GND), J1.39 (GND), K1.3, K1.4, U1.4 (Gnd), U2.CN3_4 (GND_CN3), U2.CN4_2 (GND_CN4)
UART2_Nucleo_RX_PM25_TX: K1.10, U2.CN3_2 (PA10)
UART2_Nucleo_TX_PM25_RX: K1.8, U2.CN3_1 (PA9)
UART3_Nucleo_RX_CO2_TX: U1.3 (Tx), U2.CN3_5 (PA12)
UART3_Nucleo_TX_CO2_RX: U1.2 (Rx), U2.CN3_6 (PB0)
UART_Nucleo_RX_RPi_TX: J1.8 (GPIO14/TXD), U2.CN4_10 (PA3)
UART_Nucleo_TX_RPi_RX: J1.10 (GPIO15/RXD), U2.CN4_5 (PA2)

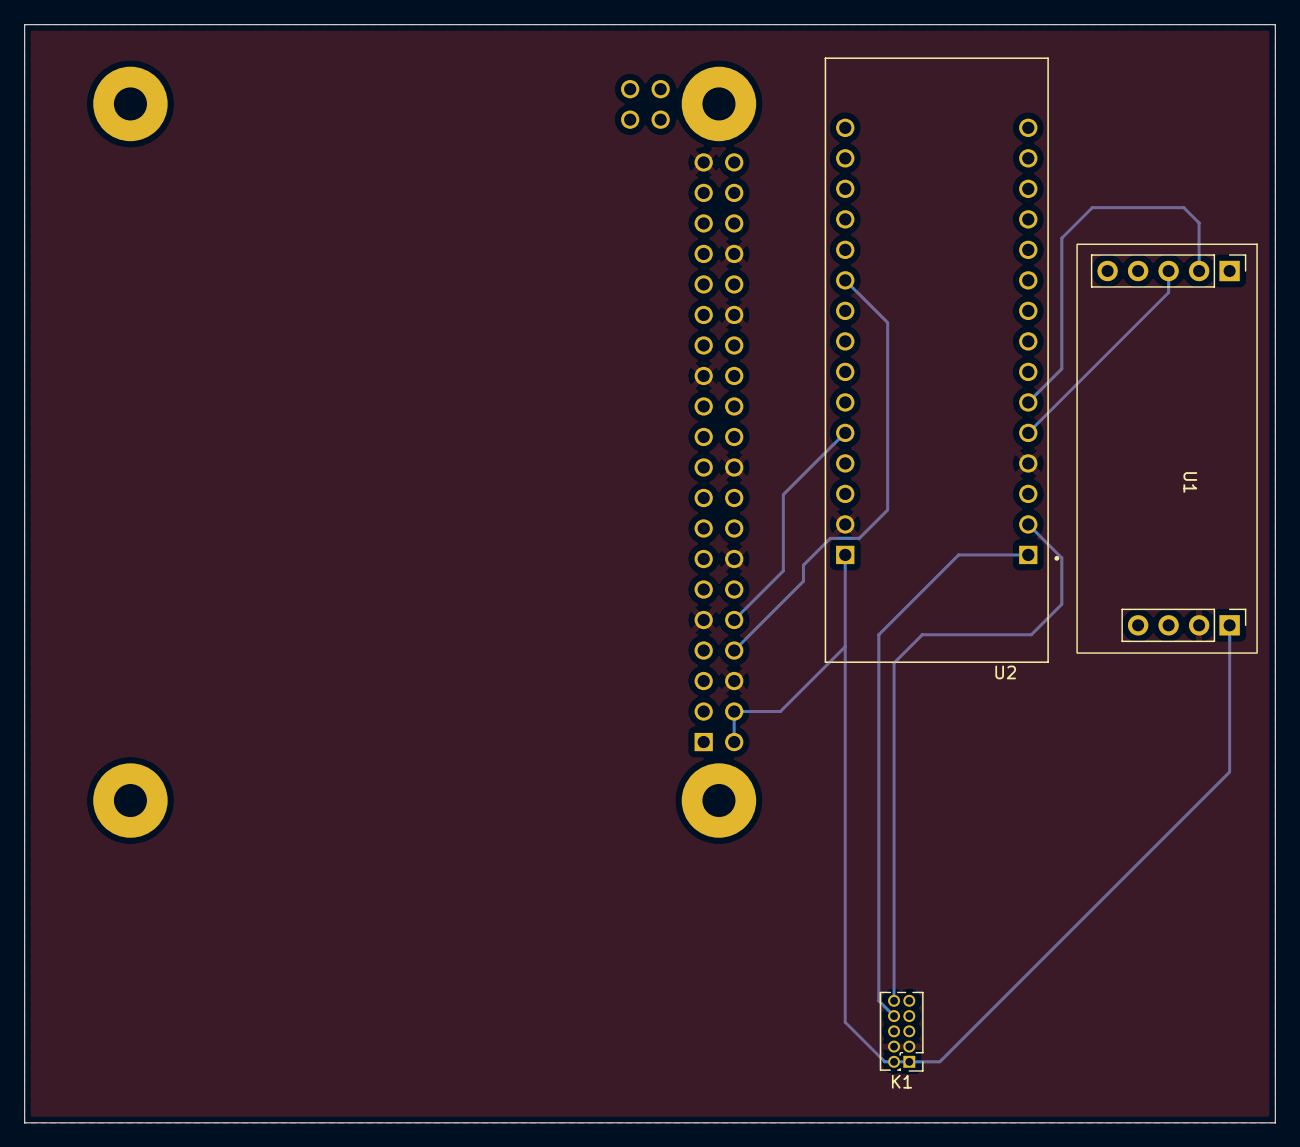
[picture p43: board Shield_Raspy.kicad_pcb from above]

Board: 2 copper layers, 104.1 x 91.4 mm, 4 parts (1 on the bottom side), 8 nets.
