AdrienEMSE/PE-SM/Kicad/Boost/Boost.kicad_pcb

## KiCad design Kicad/Boost/Boost.kicad_pcb (2023-03-16)

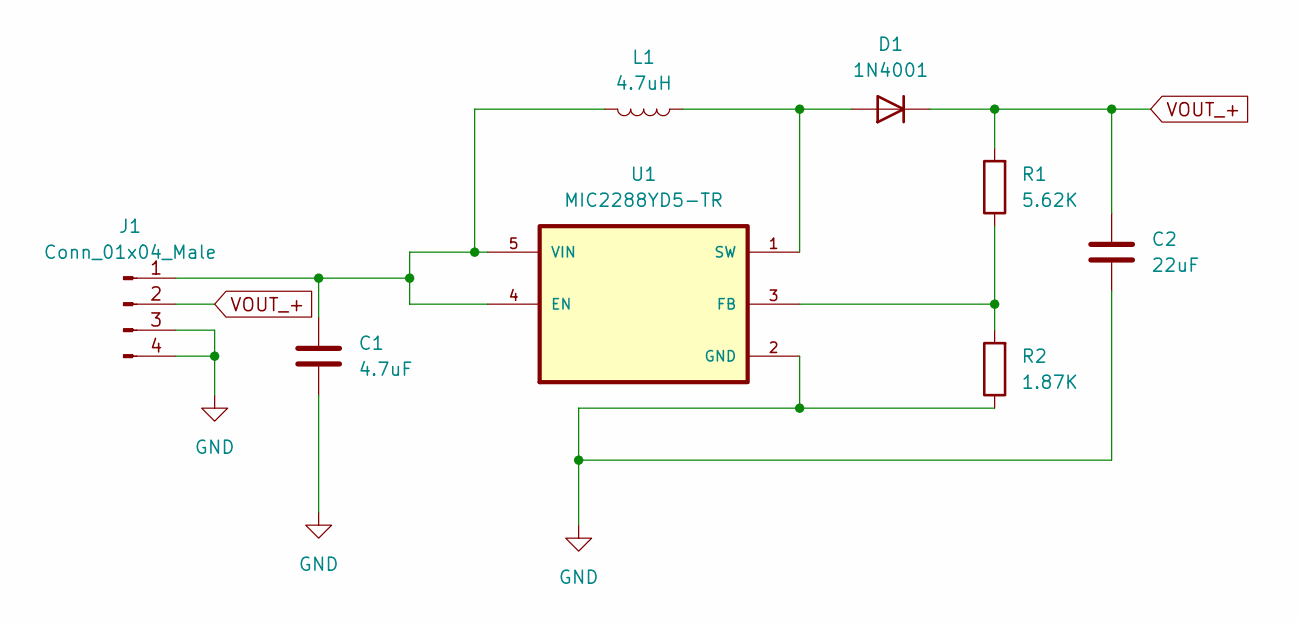
[picture p44: schematic Boost.kicad_sch]

Parts:
C1: 4.7uF; C_0603_1608Metric
C2: 22uF; C_0805_2012Metric
D1: 1N4001; D_SOD-123
J1: Conn_01x04_Male; PinHeader_1x04_P2.54mm_Vertical
L1: 4.7uH; L_Vishay_IHLP-2525
R1: 5.62K; R_0805_2012Metric
R2: 1.87K; R_0805_2012Metric
U1: MIC2288YD5-TR; TSOT-23-5; PARTREV B

Connections:
GND: C1.2, C2.2, J1.3, J1.4, R2.1, U1.2 (GND)
unnamed: C1.1, J1.1, L1.2, U1.4 (EN), U1.5 (VIN)
unnamed: D1.2 (A), L1.1, U1.1 (SW)
unnamed: R1.1, R2.2, U1.3 (FB)
VOUT_+: C2.1, D1.1 (K), J1.2, R1.2

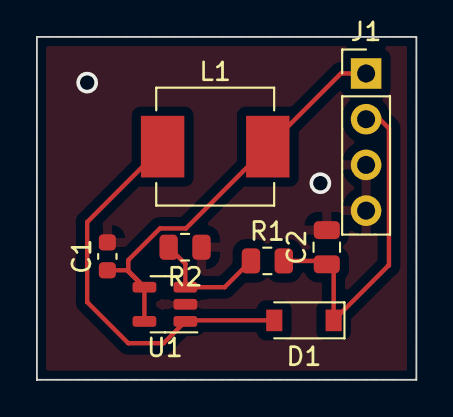
[picture p45: board Boost.kicad_pcb from above]

Board: 2 copper layers, 21.1 x 19.0 mm, 8 parts (0 on the bottom side), 5 nets.
