AdrienEMSE/PE-SM/Kicad/Capteur de fourdre/Capteur de fourdre.kicad_pcb

## KiCad design Kicad/Capteur de fourdre/Capteur de fourdre.kicad_pcb (2023-03-16)

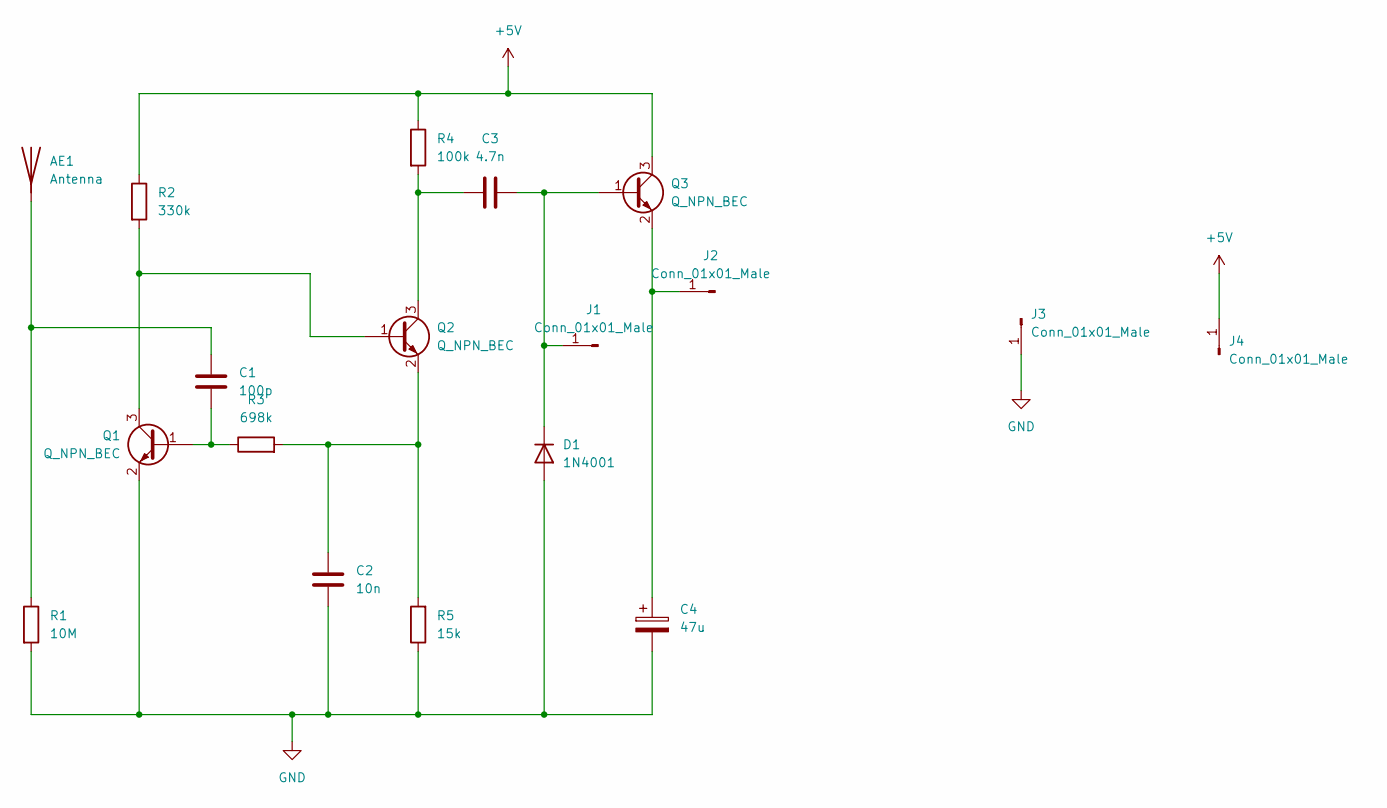
[picture p46: schematic Capteur de fourdre.kicad_sch]

Parts:
AE1: Antenna; PinHeader_1x01_P2.54mm_Vertical
C1: 100p; C_0603_1608Metric
C2: 10n; C_0805_2012Metric
C3: 4.7n; C_0603_1608Metric
C4: 47u; CP_Elec_6.3x5.8
D1: 1N4001; D_SOD-123
J1, J2, J3, J4: Conn_01x01_Male; PinHeader_1x01_P2.54mm_Vertical
Q1, Q2, Q3: Q_NPN_BEC; SOT-23
R1: 10M; R_0805_2012Metric
R2: 330k; R_0805_2012Metric
R3: 698k; R_0805_2012Metric
R4: 100k; R_0805_2012Metric
R5: 15k; R_0805_2012Metric

Connections:
+5V: J4.1, Q3.3 (C), R2.1, R4.1
GND: C2.2, C4.2, D1.2 (A), J3.1, Q1.2 (E), R1.2, R5.1
unnamed: AE1.1 (A), C1.1, R1.1
unnamed: C1.2, Q1.1 (B), R3.1
unnamed: C2.1, Q2.2 (E), R3.2, R5.2
unnamed: C3.1, Q2.3 (C), R4.2
unnamed: C3.2, D1.1 (K), J1.1, Q3.1 (B)
unnamed: C4.1, J2.1, Q3.2 (E)
unnamed: Q1.3 (C), Q2.1 (B), R2.2

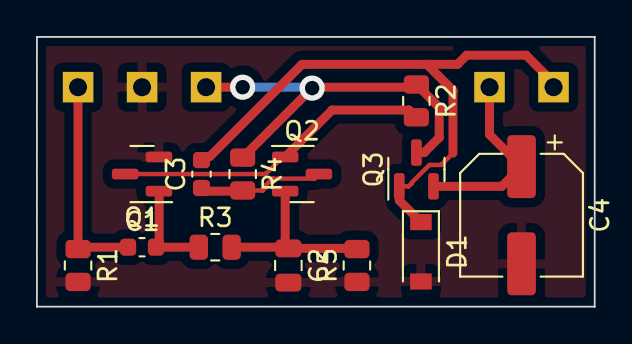
[picture p47: board Capteur de fourdre.kicad_pcb from above]

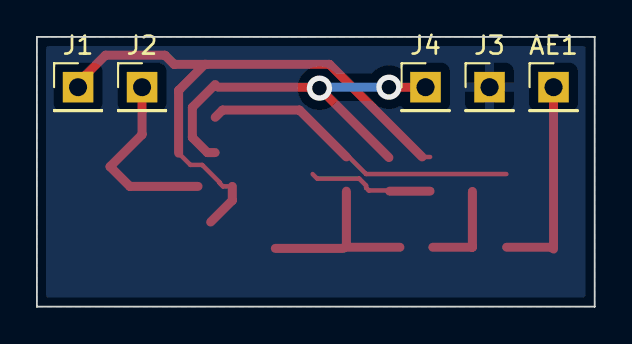
[picture p48: board Capteur de fourdre.kicad_pcb from below]

Board: 2 copper layers, 31.0 x 15.0 mm, 18 parts (5 on the bottom side), 9 nets.
