AdrienEMSE/PE-SM/Kicad/Shield_Déporté/Shield_Déporté.kicad_pcb

## KiCad design Kicad/Shield_Déporté/Shield_Déporté.kicad_pcb (2023-03-16)

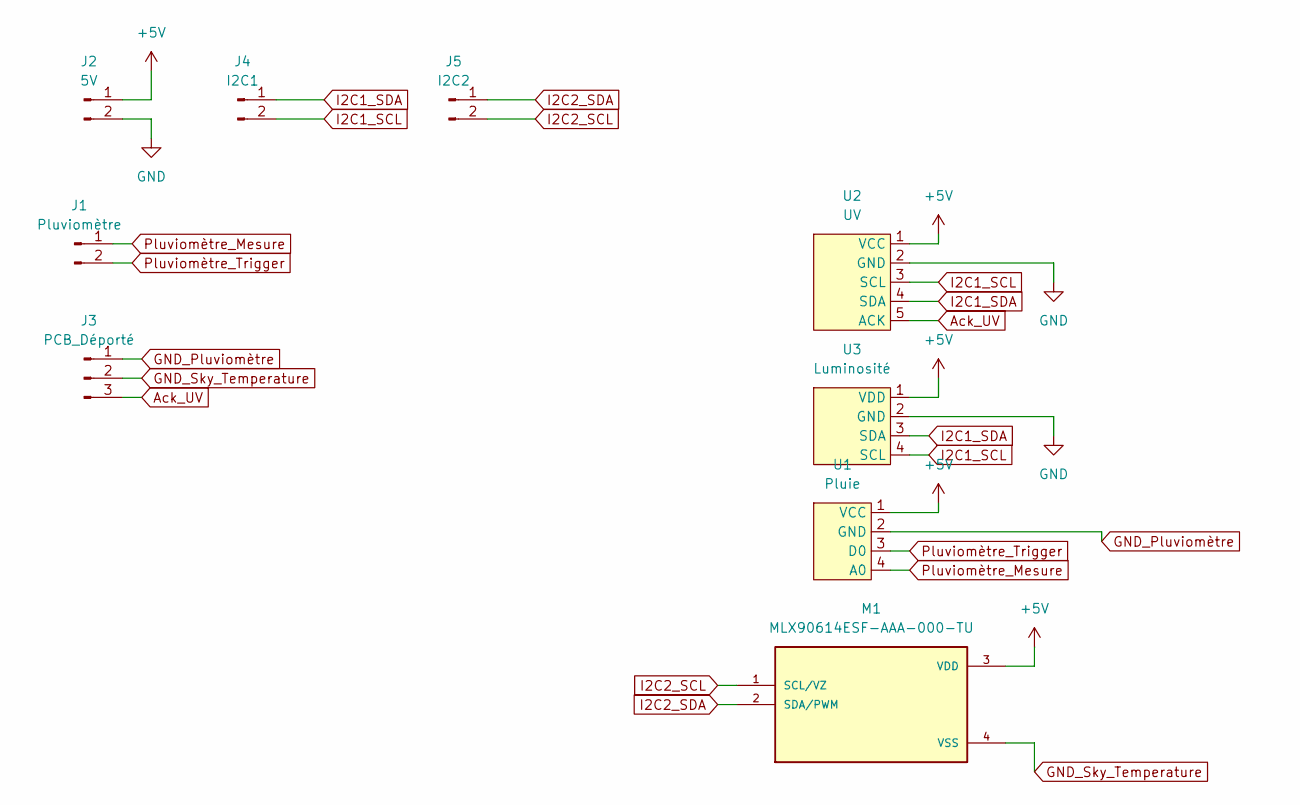
[picture p49: schematic Shield_Déporté.kicad_sch]

Parts:
J1: Pluviomètre; JST_EH_B2B-EH-A_1x02_P2.50mm_Vertical
J2: 5V; JST_EH_B2B-EH-A_1x02_P2.50mm_Vertical
J3: PCB_Déporté; JST_EH_B3B-EH-A_1x03_P2.50mm_Vertical
J4: I2C1; JST_EH_B2B-EH-A_1x02_P2.50mm_Vertical
J5: I2C2; JST_EH_B2B-EH-A_1x02_P2.50mm_Vertical
M1: MLX90614ESF-AAA-000-TU; TO254P942H425-4; PARTREV 13
U1: Pluie
U2: UV
U3: Luminosité; Luminosite

Connections:
+5V: J2.1, M1.3 (VDD), U1.1 (VCC), U2.1 (VCC), U3.1 (VDD)
Ack_UV: J3.3, U2.5 (ACK)
GND: J2.2, U2.2 (GND), U3.2 (GND)
GND_Pluviomètre: J3.1, U1.2 (GND)
GND_Sky_Temperature: J3.2, M1.4 (VSS)
I2C1_SCL: J4.2, U2.3 (SCL), U3.4 (SCL)
I2C1_SDA: J4.1, U2.4 (SDA), U3.3 (SDA)
I2C2_SCL: J5.2, M1.1 (SCL/VZ)
I2C2_SDA: J5.1, M1.2 (SDA/PWM)
Pluviomètre_Mesure: J1.1, U1.4 (A0)
Pluviomètre_Trigger: J1.2, U1.3 (D0)

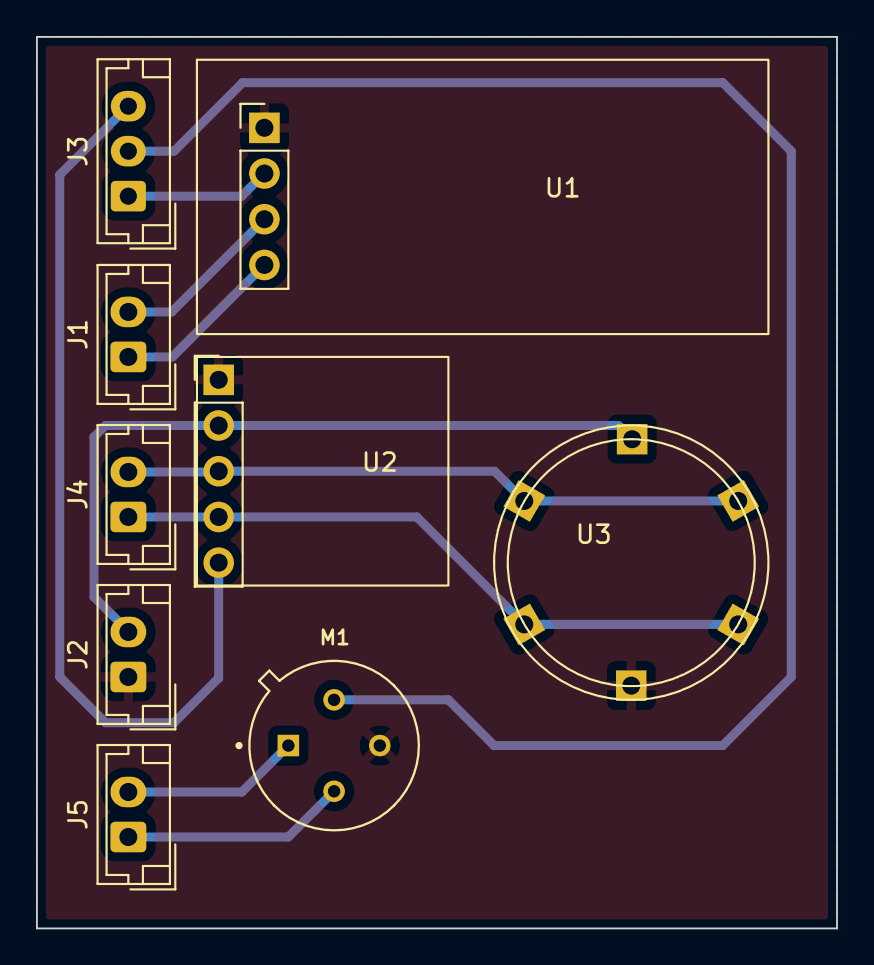
[picture p50: board Shield_Déporté.kicad_pcb from above]

Board: 2 copper layers, 44.5 x 49.5 mm, 9 parts (0 on the bottom side), 11 nets.
