AdrienEMSE/PE-SM/Kicad/Anemometre/Anemometre.kicad_pcb

## KiCad design Kicad/Anemometre/Anemometre.kicad_pcb (2023-03-16)

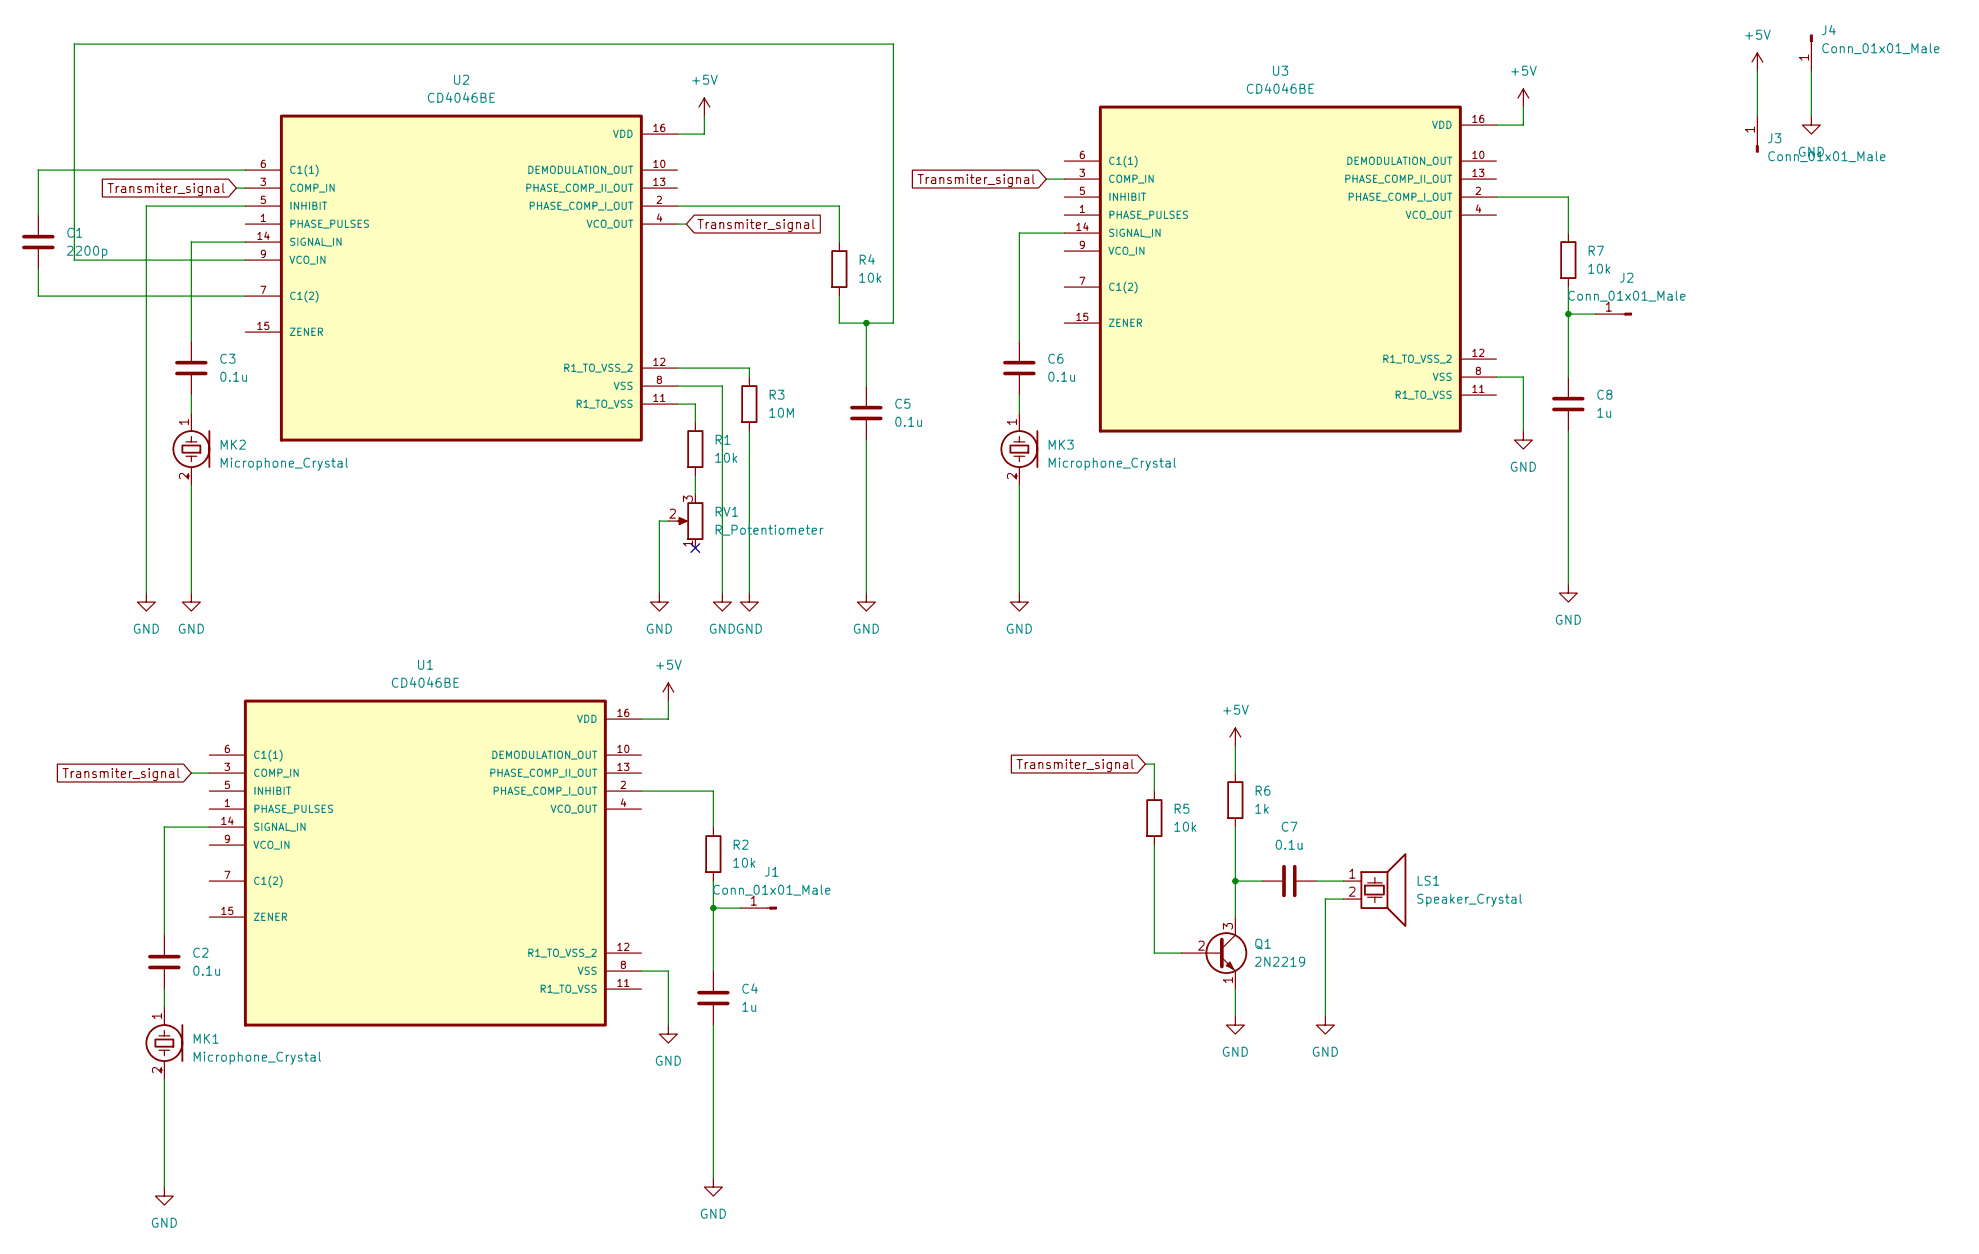
[picture p51: schematic Anemometre.kicad_sch]

Parts:
C1: 2200p; C_0805_2012Metric
C2, C3, C5, C6, C7: 0.1u; C_0805_2012Metric
C4, C8: 1u; C_0603_1608Metric
J1, J2, J3, J4: Conn_01x01_Male; PinHeader_1x01_P2.54mm_Vertical
LS1: Speaker_Crystal; PinHeader_1x02_P2.54mm_Vertical
MK1, MK2, MK3: Microphone_Crystal; PinHeader_1x02_P2.54mm_Vertical
Q1: 2N2219; SOT-23
R1, R2, R4, R5, R7: 10k; R_0603_1608Metric
R3: 10M; R_0603_1608Metric
R6: 1k; R_0603_1608Metric
RV1: R_Potentiometer; Potentiometer_Vishay_TS53YL_Vertical
U1, U2, U3: CD4046BE; DIP794W45P254L1969H508Q16

Connections:
+5V: J3.1, R6.1, U1.16 (VDD), U2.16 (VDD), U3.16 (VDD)
GND: C4.2, C5.2, C8.2, J4.1, LS1.2, MK1.2 (+), MK2.2 (+), MK3.2 (+), Q1.1 (E), R3.2, RV1.2, U1.8 (VSS), U2.5 (INHIBIT), U2.8 (VSS), U3.8 (VSS)
unnamed: C1.1, U2.6 (C1(1))
unnamed: C1.2, U2.7 (C1(2))
unnamed: C2.1, U1.14 (SIGNAL_IN)
unnamed: C2.2, MK1.1 (-)
unnamed: C3.1, U2.14 (SIGNAL_IN)
unnamed: C3.2, MK2.1 (-)
unnamed: C4.1, J1.1, R2.2
unnamed: C5.1, R4.2, U2.9 (VCO_IN)
unnamed: C6.1, U3.14 (SIGNAL_IN)
unnamed: C6.2, MK3.1 (-)
unnamed: C7.1, LS1.1
unnamed: C7.2, Q1.3 (C), R6.2
unnamed: C8.1, J2.1, R7.2
unnamed: Q1.2 (B), R5.2
unnamed: R1.1, U2.11 (R1_TO_VSS)
unnamed: R1.2, RV1.3
unnamed: R2.1, U1.2 (PHASE_COMP_I_OUT)
unnamed: R3.1, U2.12 (R1_TO_VSS_2)
unnamed: R4.1, U2.2 (PHASE_COMP_I_OUT)
unnamed: R7.1, U3.2 (PHASE_COMP_I_OUT)
Transmiter_signal: R5.1, U1.3 (COMP_IN), U2.3 (COMP_IN), U2.4 (VCO_OUT), U3.3 (COMP_IN)

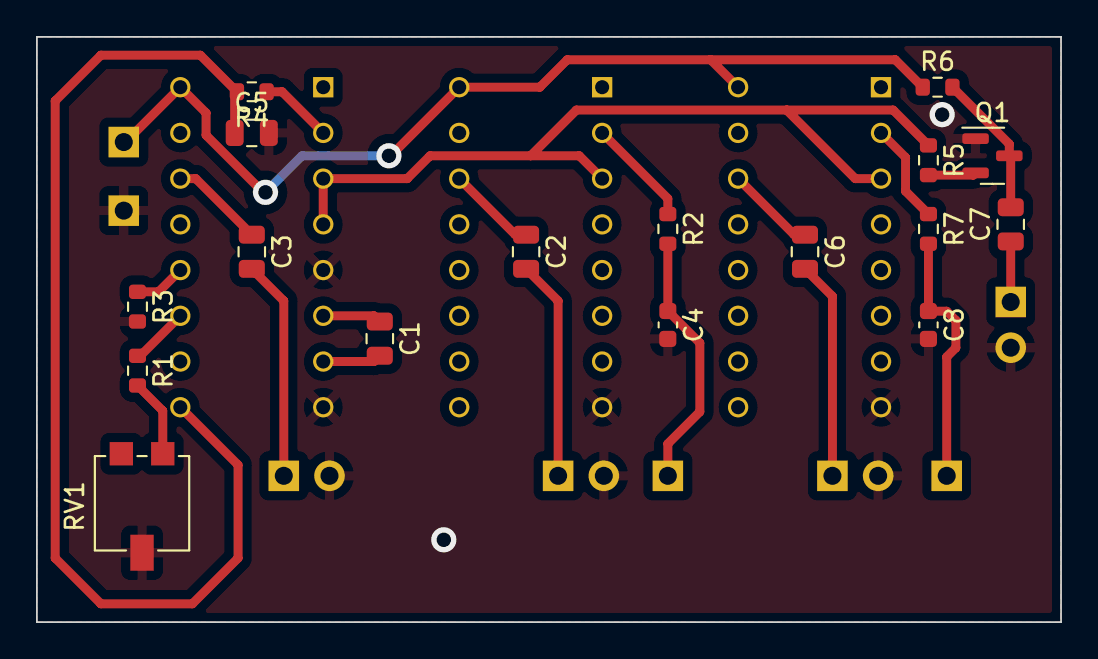
[picture p52: board Anemometre.kicad_pcb from above]

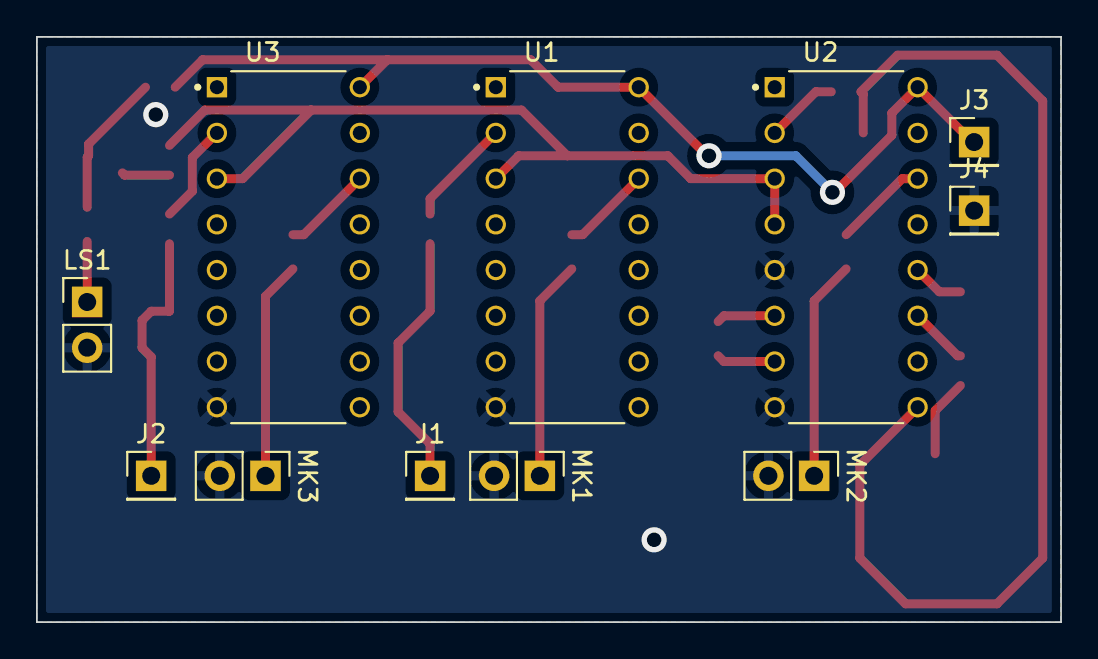
[picture p53: board Anemometre.kicad_pcb from below]

Board: 2 copper layers, 56.9 x 32.5 mm, 28 parts (11 on the bottom side), 23 nets.
