AdrienEMSE/PE-SM/(commit log)

2023-03-01 added ESP32 folder
2023-03-03 Low power ccs
2023-03-06 Code for CO2 & PM2.5 sensors, com with raspberry
2023-03-06 Add file for UART communication with Nucleo
    Allows UART communication with Nucleo, which controls C02 and PM2.5 sensors
2023-03-10 mode deepSleeep(STOP), arbre d'horloge réduit, power_voltage_scale de 1 à 3 et désactivation mode overdrive
2023-03-10 Separate gps and sensors messages
2023-03-10 PLLN 216 => 192 [temps de démarrage de malade]
2023-03-10 Pas possible de descendre la fréquence plus bas
2023-03-16 PCBs des différentes parties de la station
    [Anemometre.kicad_pcb, Anemometre.kicad_sch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]
2023-03-16 resolution probleme envoi + petites modifications
    [main.cpp]
2023-03-16 Script to send indoor sensors data to Thingsboard
2023-03-16 Interrupt thunder ok
2023-03-22 switched from nmos to pmos for gps
2023-03-22 Added power toggle for lumi sensor
2023-03-22 oublié le pin ack_uv
2023-03-23 alimentation pin anemo + delay?
2023-03-24 added 3D file
    [Door.ipt, Ensemble.0001.iam, Ensemble.iam, NUCLEO-F429ZI board.sldprt, NUCLEO-F429ZI--3DModel-STEP-56544.SLDASM, PE.stl, STM32F103CBT6.sldprt, STM32lqfp144.sldprt]
2023-03-29 3D files
    [Aeration.ipt, Aeration.stl, AnemoHolder.0002.ipt, AnemoHolder.ipt, AnemoHolder.stl, Anemometre-v1.f3d, Anemometre-v1.ipt, BatterieHolder.0002.ipt]
2023-03-29 Add 3D pieces for server's case
    [base.ipt, piece_interieur.ipt, pied.ipt]
